baerm56/477grp14/led_sensor/3d_daughterboard_v0_2.jpg

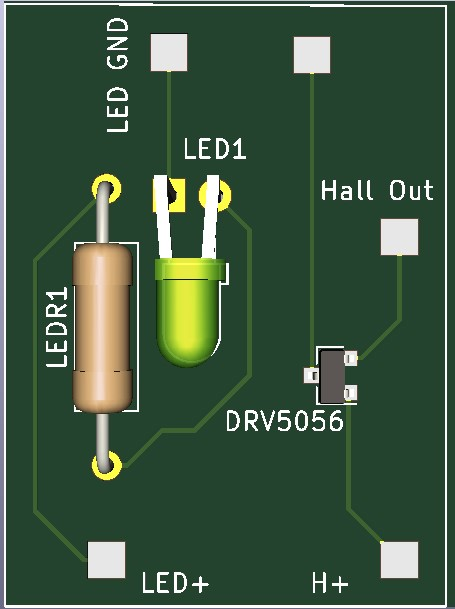
led_sensor/3d_daughterboard_v0_2.jpg
