baerm56/477grp14/Main_Board/Main_Board.png

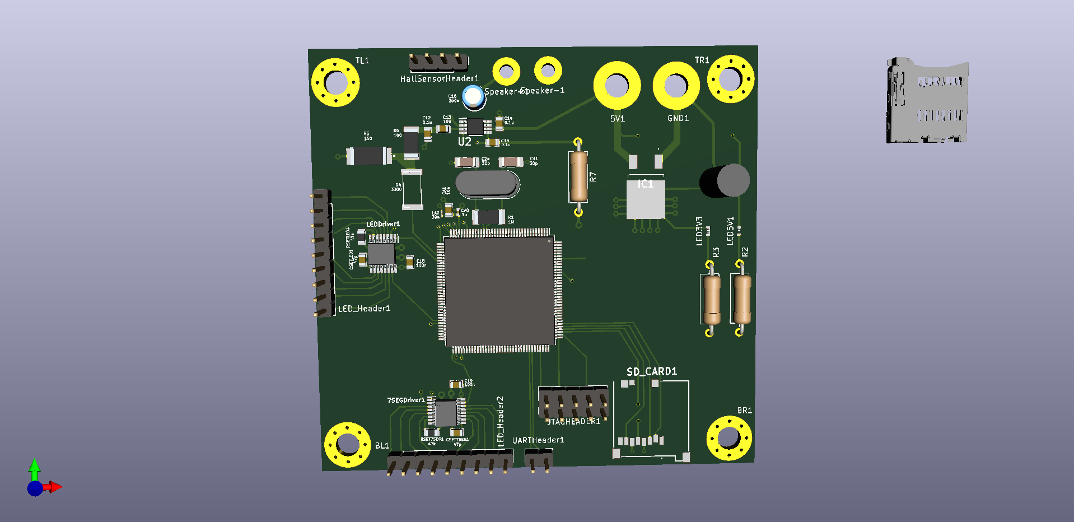
Main_Board/Main_Board.png
