baerm56/477grp14/README.md

# 477grp14
This is our senior design project
