baerm56/477grp14/led_sensor/3d_daughterboard.jpg

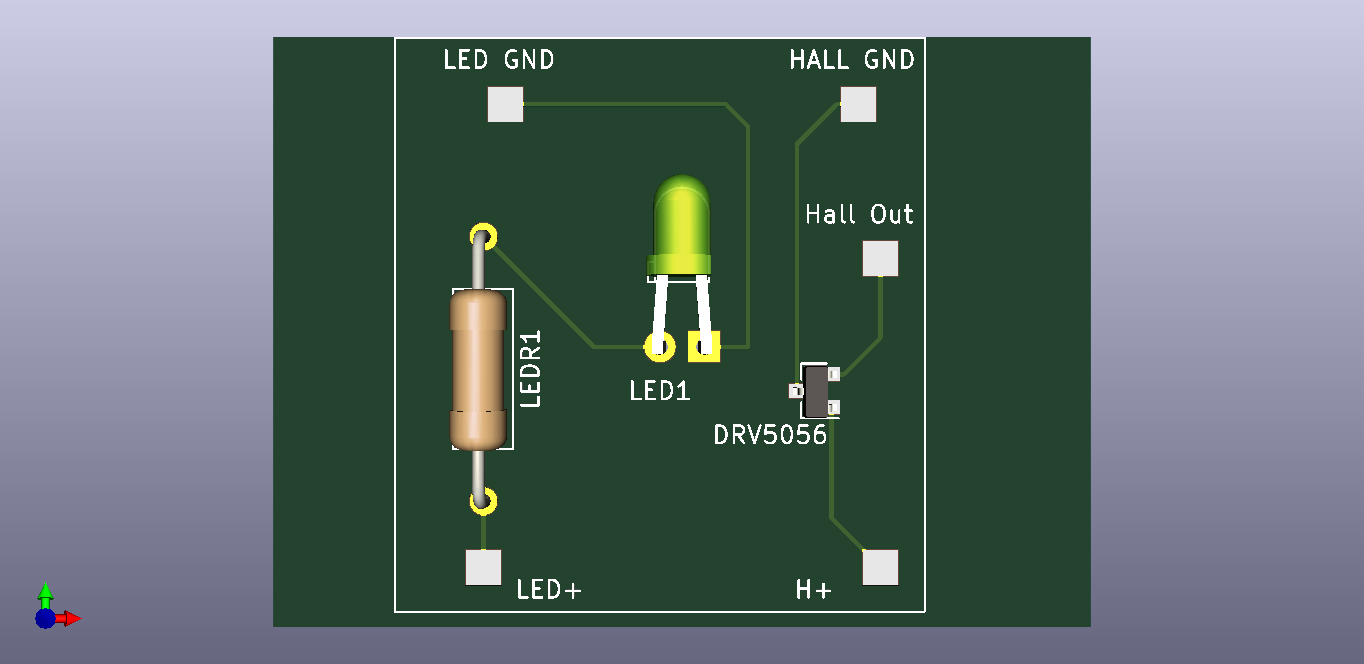
led_sensor/3d_daughterboard.jpg
