baerm56/477grp14/led_sensor/daughterboard_pcb.jpg

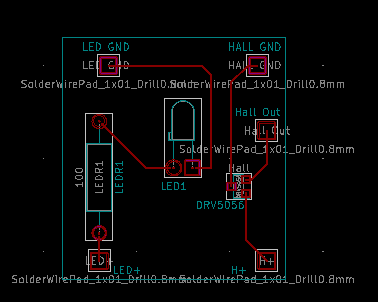
led_sensor/daughterboard_pcb.jpg
