baerm56/477grp14/led_sensor/NewDaughterboard.png

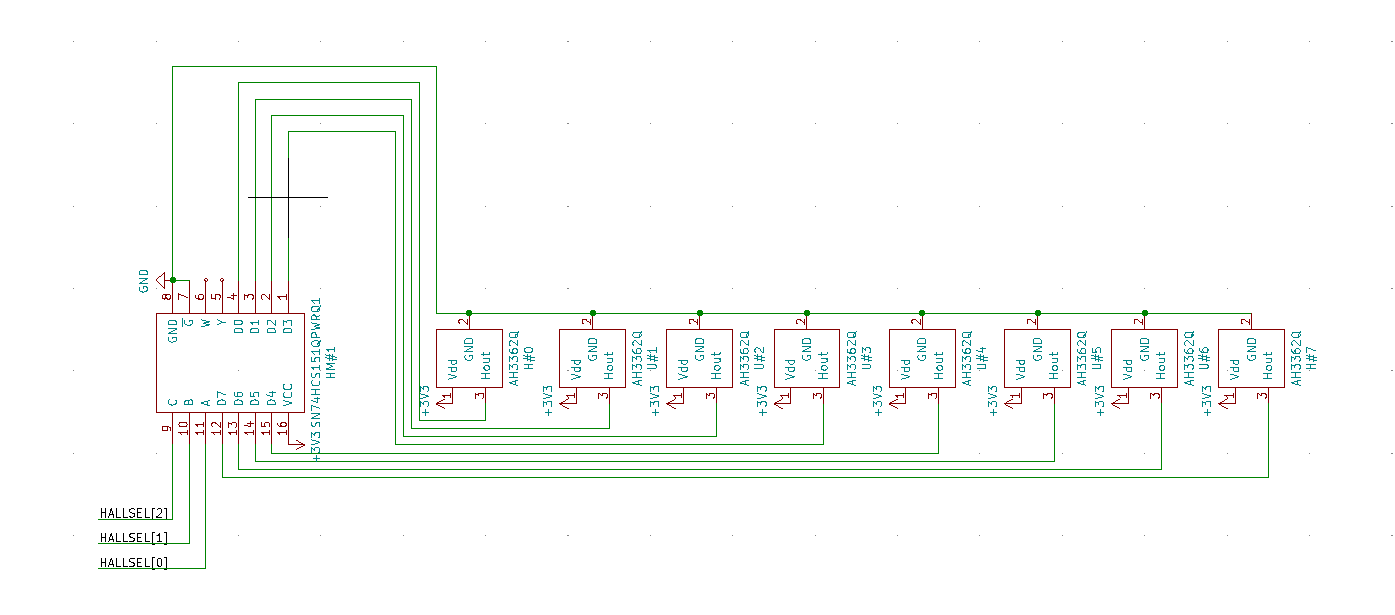
led_sensor/NewDaughterboard.png
