baerm56/477grp14/led_sensor/PCB-Daughterboard.png

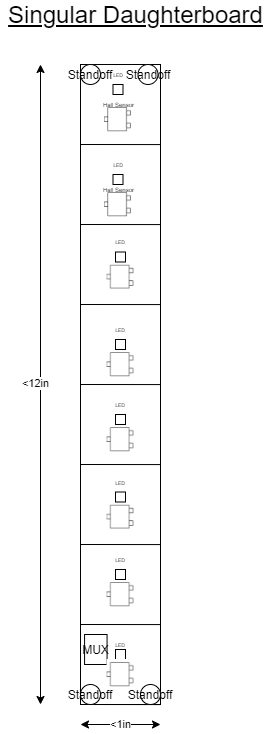
led_sensor/PCB-Daughterboard.png
