baerm56/477grp14/led_sensor/PCB-Daughterboards Layout.png

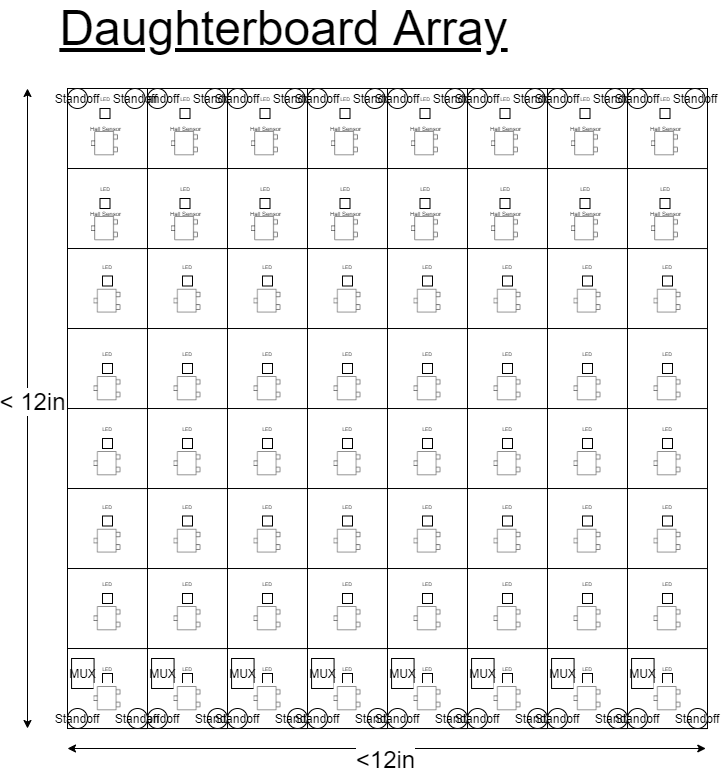
led_sensor/PCB-Daughterboards Layout.png
