baerm56/477grp14/Main_Board/Main_Board_3.png

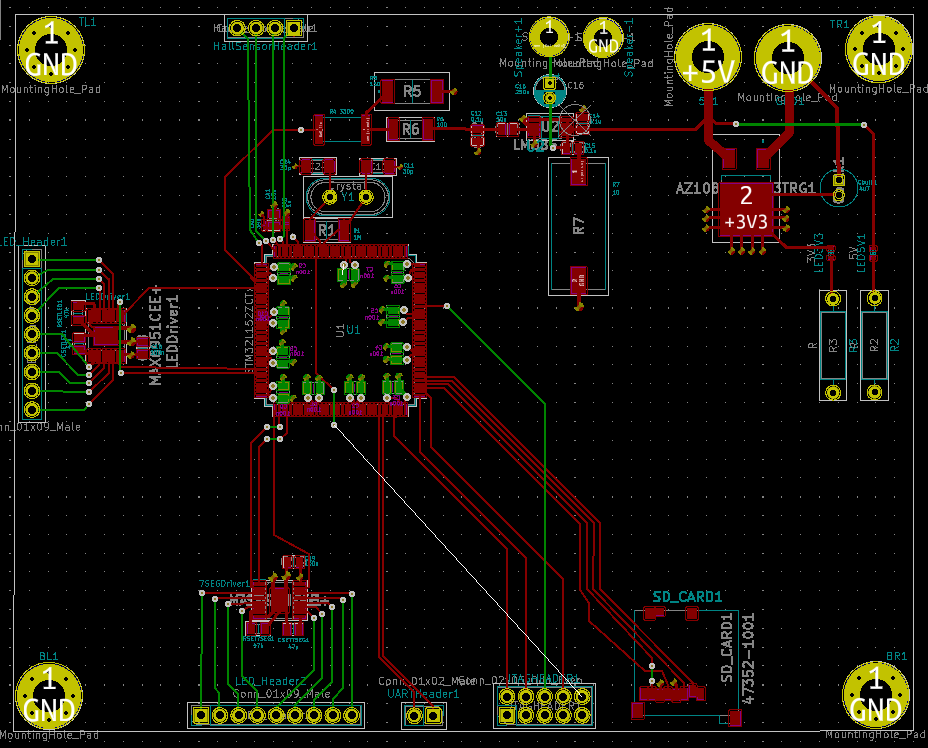
Main_Board/Main_Board_3.png
