baerm56/477grp14/Main_Board/MainBoardv0_1.jpg

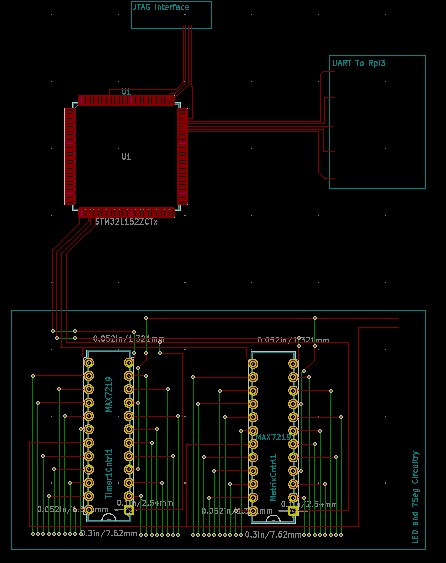
Main_Board/MainBoardv0_1.jpg
