baerm56/477grp14/Main_Board/PCB-Mainboard.png

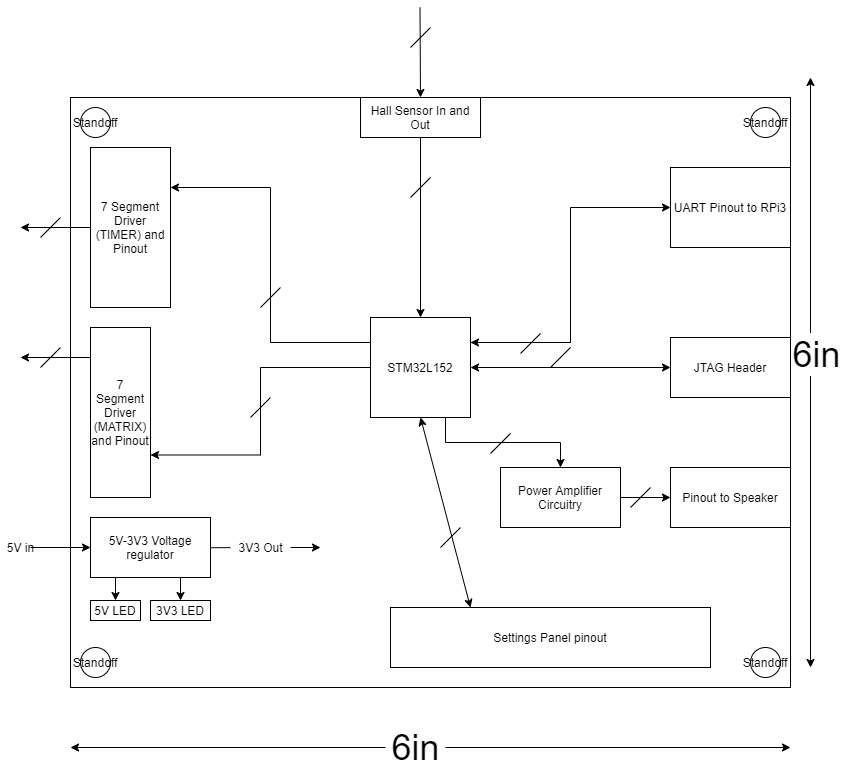
Main_Board/PCB-Mainboard.png
