baerm56/477grp14/Main_Board/PCB-Mainboard_2.png

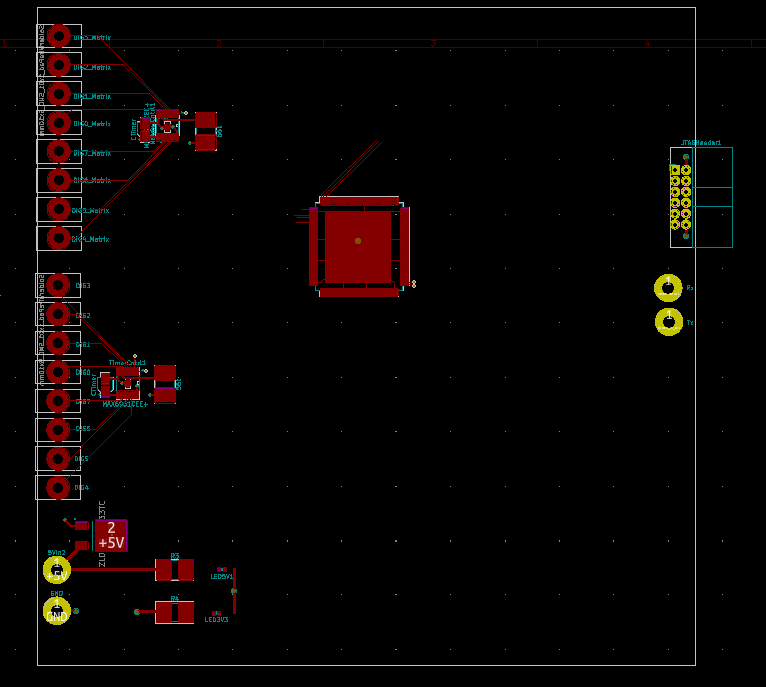
Main_Board/PCB-Mainboard_2.png
