baerm56/477grp14/PCB Screenshots/Led Daughterboard/Led_Hall_Circuit_pcb.png

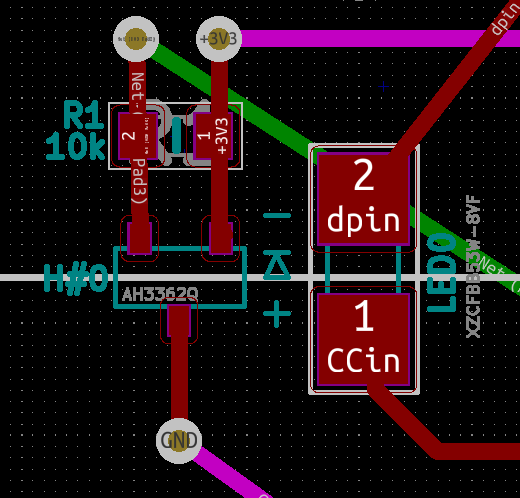
PCB Screenshots/Led Daughterboard/Led_Hall_Circuit_pcb.png
