baerm56/477grp14/PCB Screenshots/Led Daughterboard/Multiplexer_pcb.png

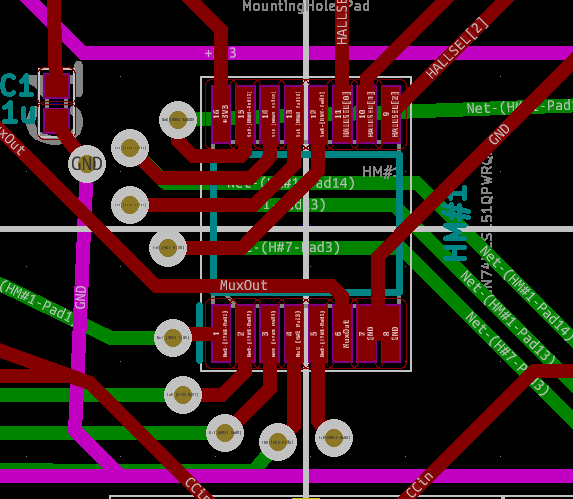
PCB Screenshots/Led Daughterboard/Multiplexer_pcb.png
