baerm56/477grp14/PCB Screenshots/Mainboard/7Seg_Driver_Circuit_pcb.png

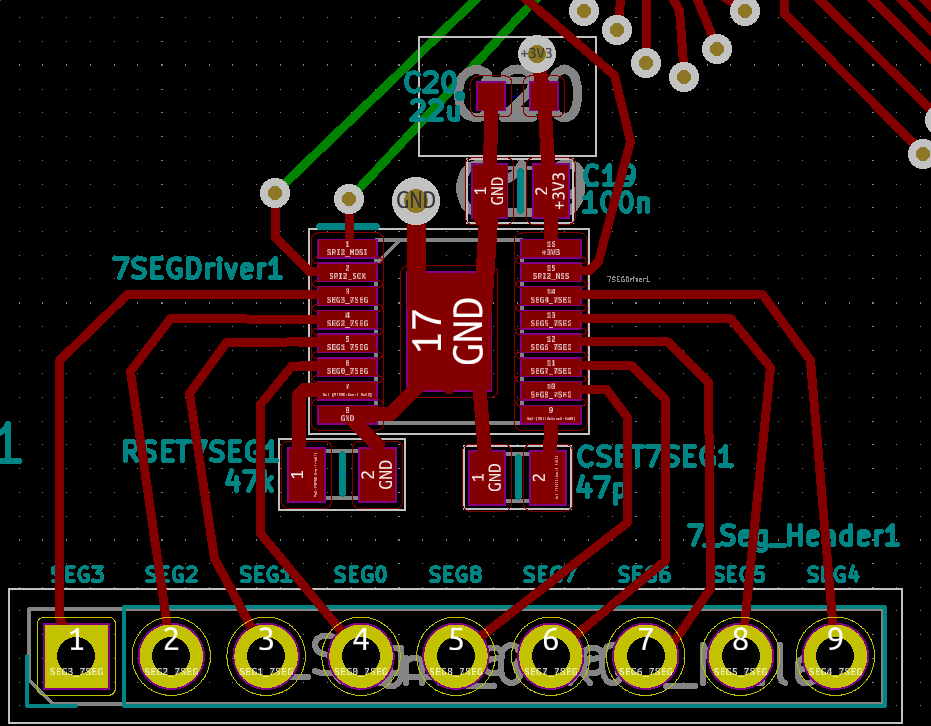
PCB Screenshots/Mainboard/7Seg_Driver_Circuit_pcb.png
