baerm56/477grp14/PCB Screenshots/Mainboard/Analog_Decoupling_pcb.png

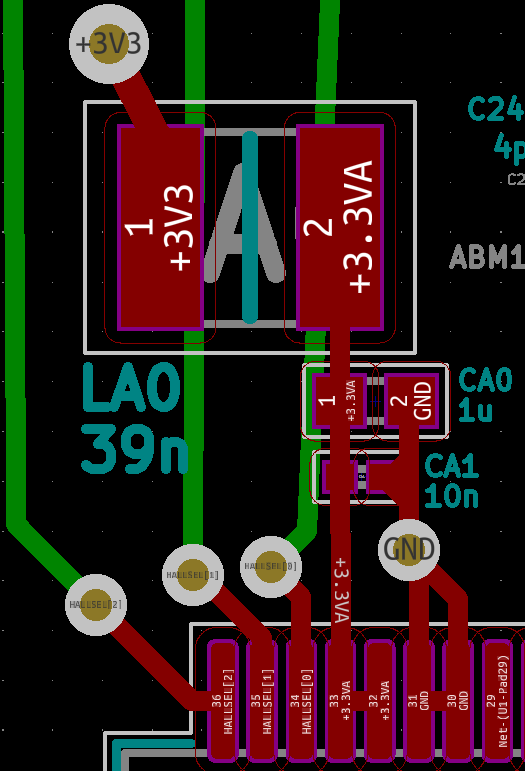
PCB Screenshots/Mainboard/Analog_Decoupling_pcb.png
