baerm56/477grp14/PCB Screenshots/Mainboard/Crystal_pcb.png

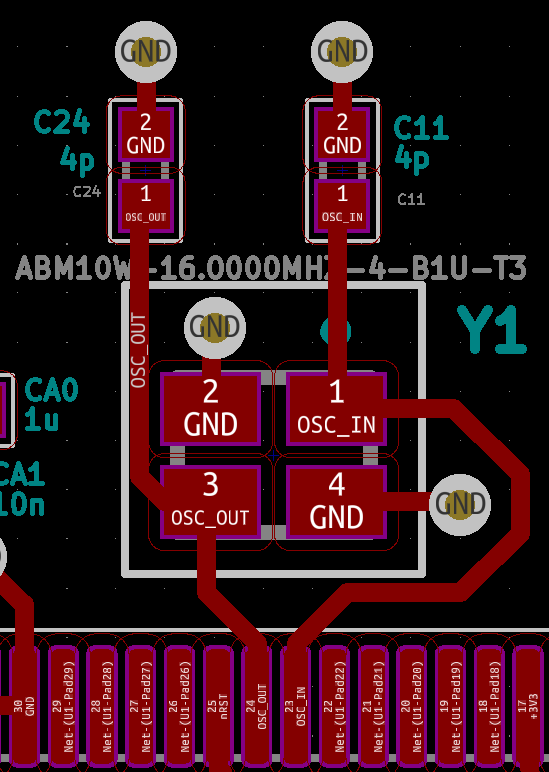
PCB Screenshots/Mainboard/Crystal_pcb.png
