baerm56/477grp14/PCB Screenshots/Mainboard/Full_Board_Blayer_pcb.png

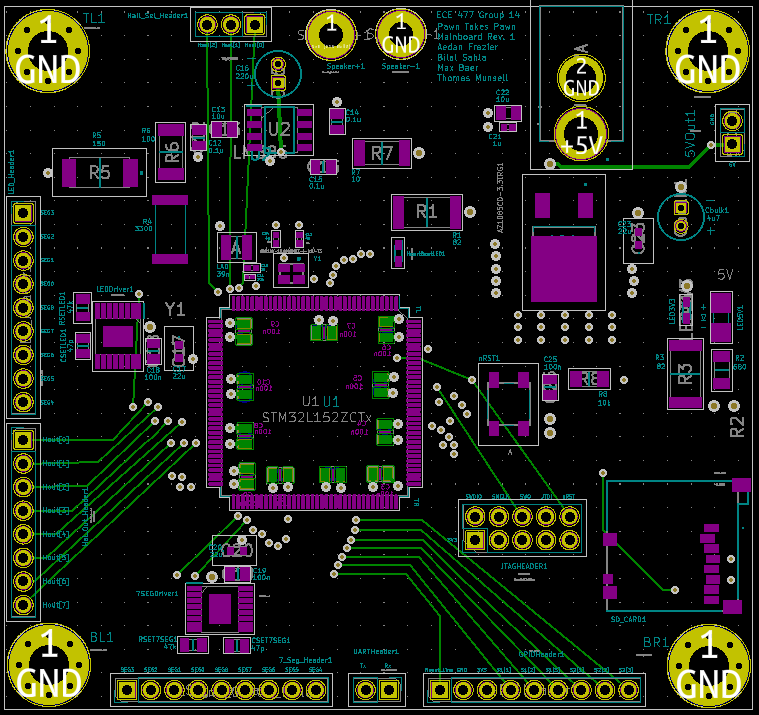
PCB Screenshots/Mainboard/Full_Board_Blayer_pcb.png
