baerm56/477grp14/PCB Screenshots/Mainboard/Full_Board_Flayer_pcb.png

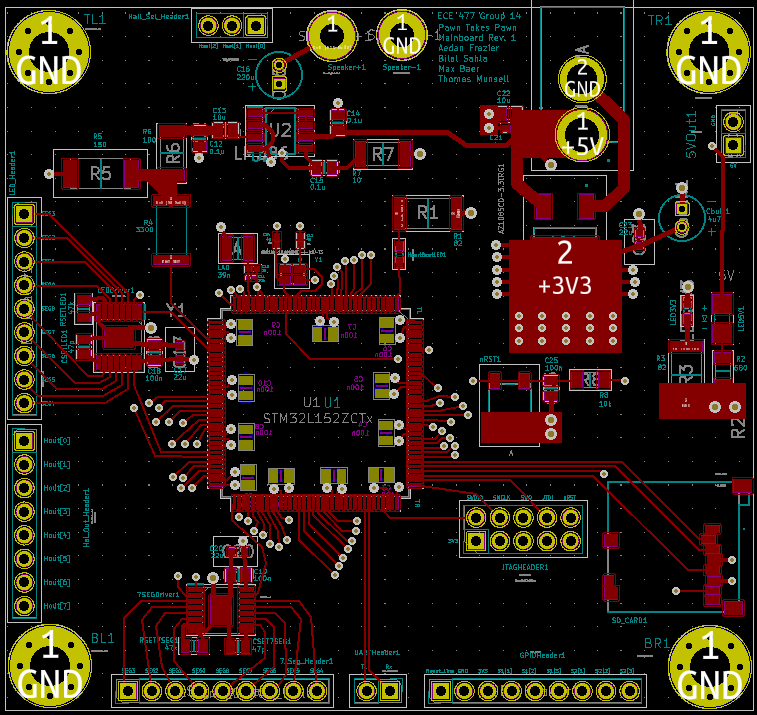
PCB Screenshots/Mainboard/Full_Board_Flayer_pcb.png
