baerm56/477grp14/PCB Screenshots/Mainboard/GPIO_Header_pcb.png

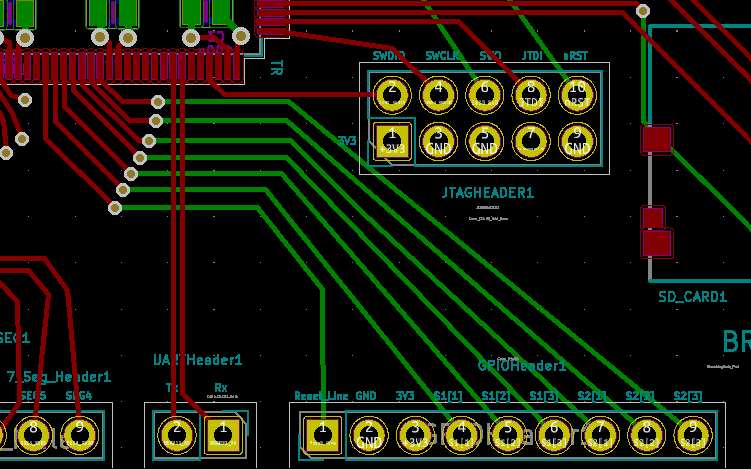
PCB Screenshots/Mainboard/GPIO_Header_pcb.png
