baerm56/477grp14/PCB Screenshots/Mainboard/Hall_Receive_Header_pcb.png

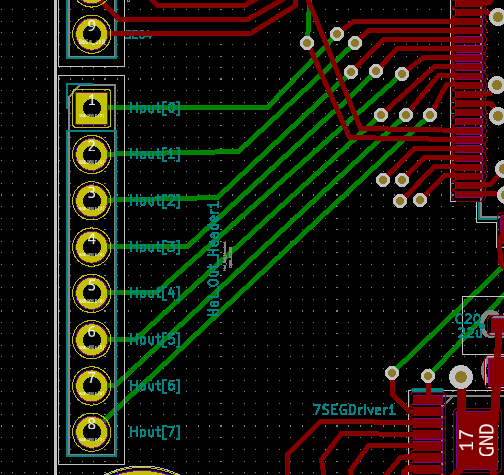
PCB Screenshots/Mainboard/Hall_Receive_Header_pcb.png
