baerm56/477grp14/PCB Screenshots/Mainboard/Hall_Select_Circuit_pcb.png

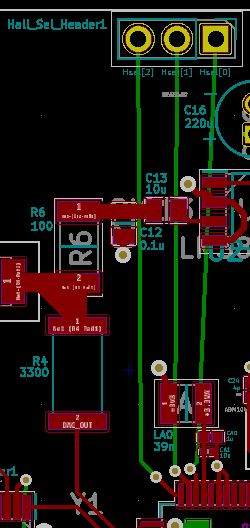
PCB Screenshots/Mainboard/Hall_Select_Circuit_pcb.png
