baerm56/477grp14/PCB Screenshots/Mainboard/Heartbeat_LED_pcb.png

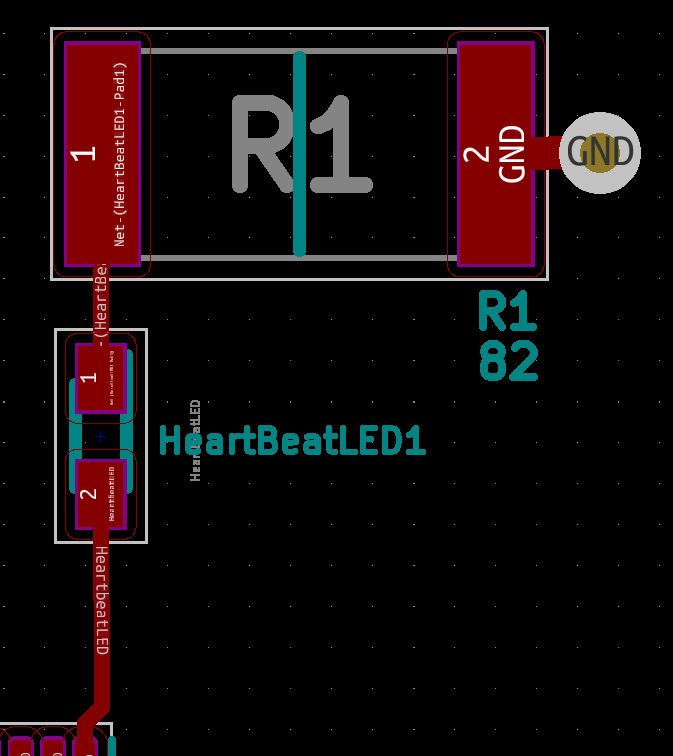
PCB Screenshots/Mainboard/Heartbeat_LED_pcb.png
