baerm56/477grp14/PCB Screenshots/Mainboard/JTAGSWD_Header_pcb.png

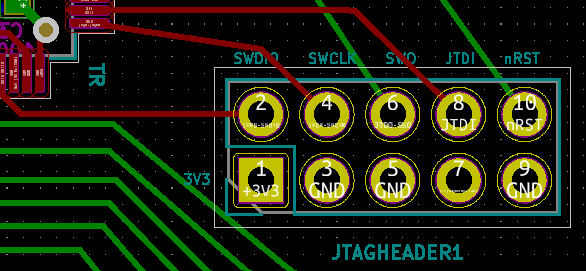
PCB Screenshots/Mainboard/JTAGSWD_Header_pcb.png
