baerm56/477grp14/PCB Screenshots/Mainboard/LDO_5Vin_Circuit_pcb.png

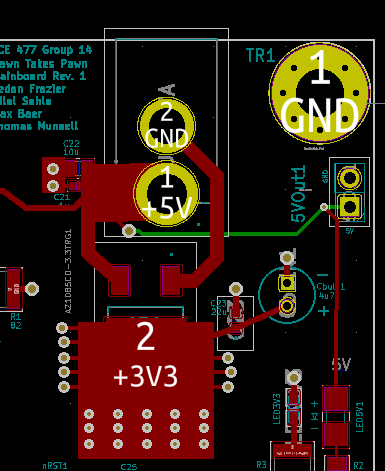
PCB Screenshots/Mainboard/LDO_5Vin_Circuit_pcb.png
