baerm56/477grp14/PCB Screenshots/Mainboard/LED_Driver_Circuit_pcb.png

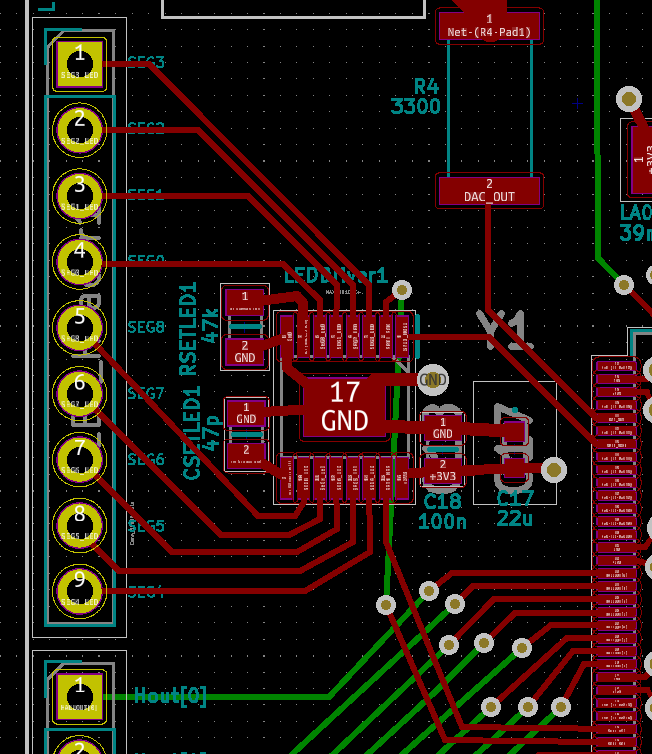
PCB Screenshots/Mainboard/LED_Driver_Circuit_pcb.png
