baerm56/477grp14/PCB Screenshots/Mainboard/MCU_Decoupling_pcb.png

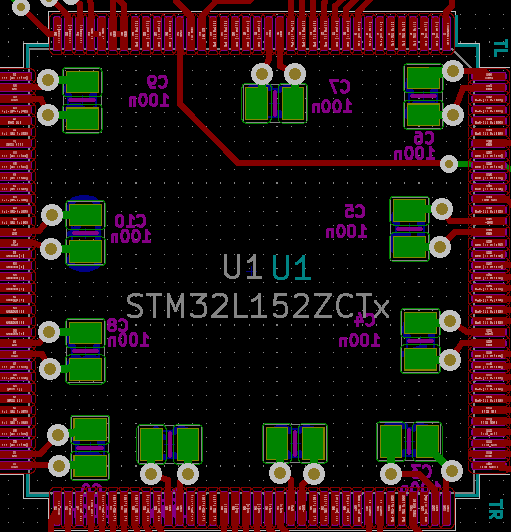
PCB Screenshots/Mainboard/MCU_Decoupling_pcb.png
