baerm56/477grp14/PCB Screenshots/Mainboard/Power_Circuit_pcb.png

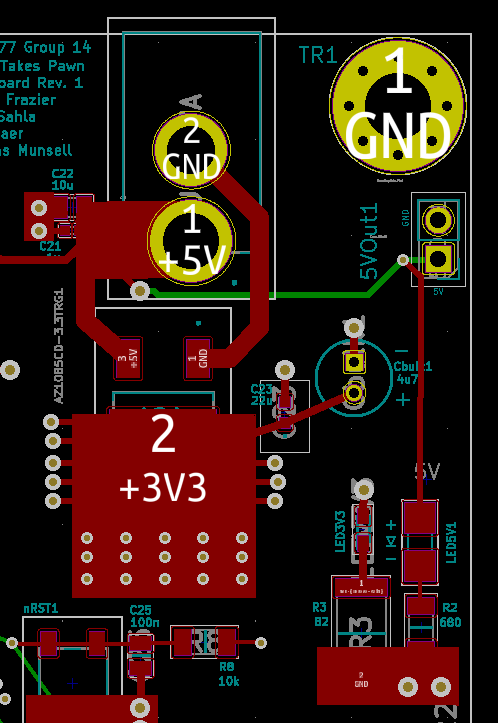
PCB Screenshots/Mainboard/Power_Circuit_pcb.png
