baerm56/477grp14/PCB Screenshots/Mainboard/PWR_Good_LED_Circuit_pcb.png

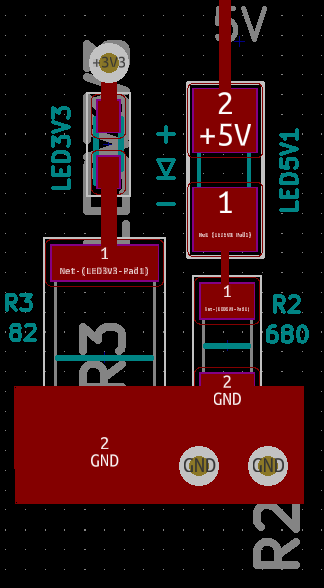
PCB Screenshots/Mainboard/PWR_Good_LED_Circuit_pcb.png
