baerm56/477grp14/PCB Screenshots/Mainboard/Reset_Circuit_pcb.png

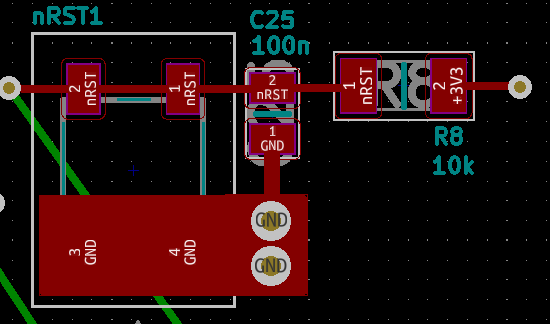
PCB Screenshots/Mainboard/Reset_Circuit_pcb.png
