baerm56/477grp14/PCB Screenshots/Mainboard/SDCard_Circuit_pcb.png

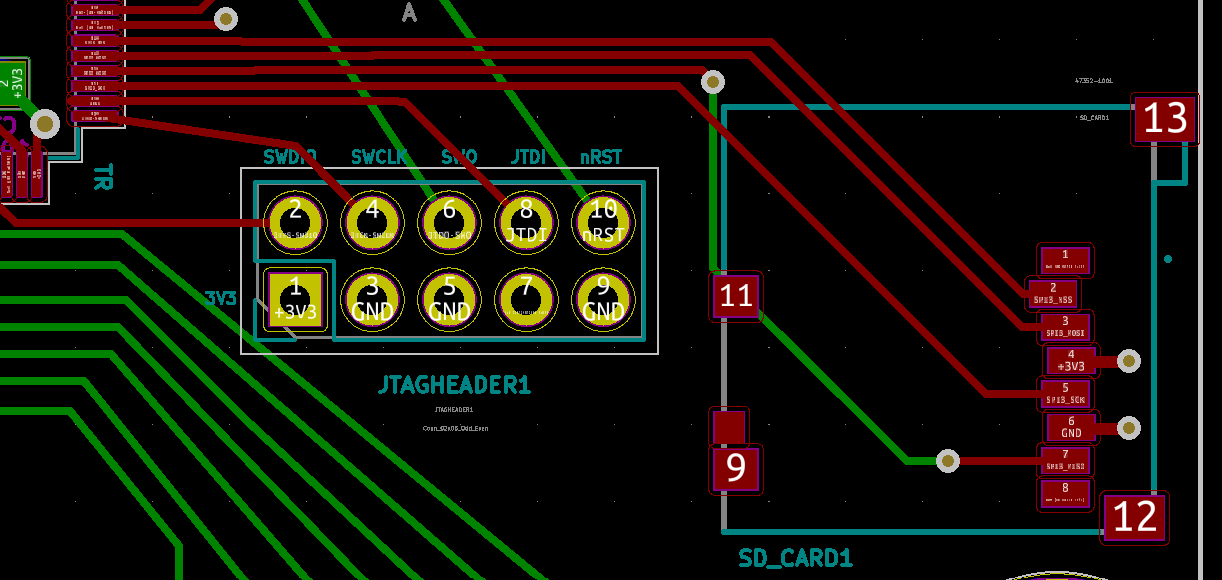
PCB Screenshots/Mainboard/SDCard_Circuit_pcb.png
