baerm56/477grp14/PCB Screenshots/Mainboard/Speaker_Circuit_pcb.png

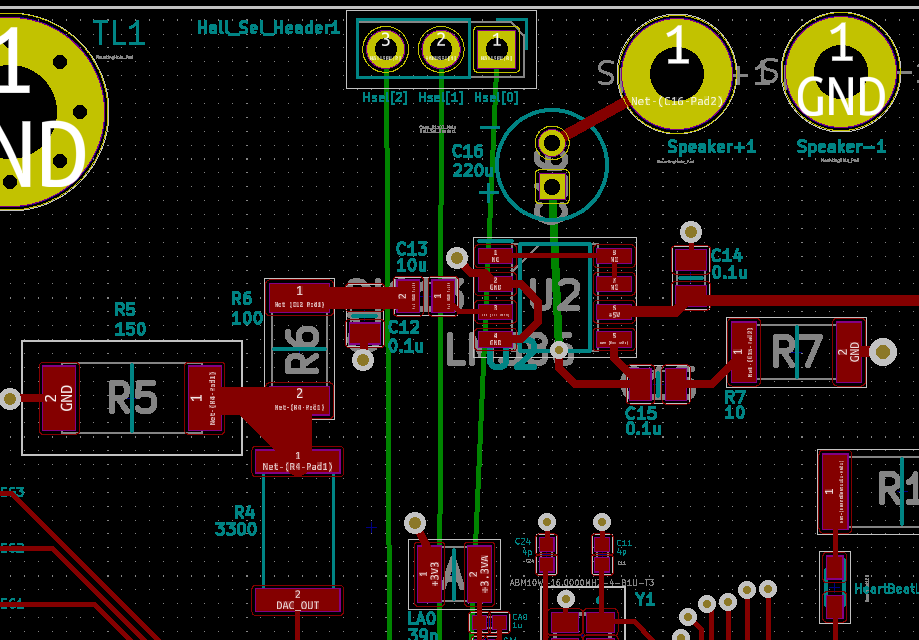
PCB Screenshots/Mainboard/Speaker_Circuit_pcb.png
