baerm56/477grp14/PCB Screenshots/Mainboard/STM32_pcb.png

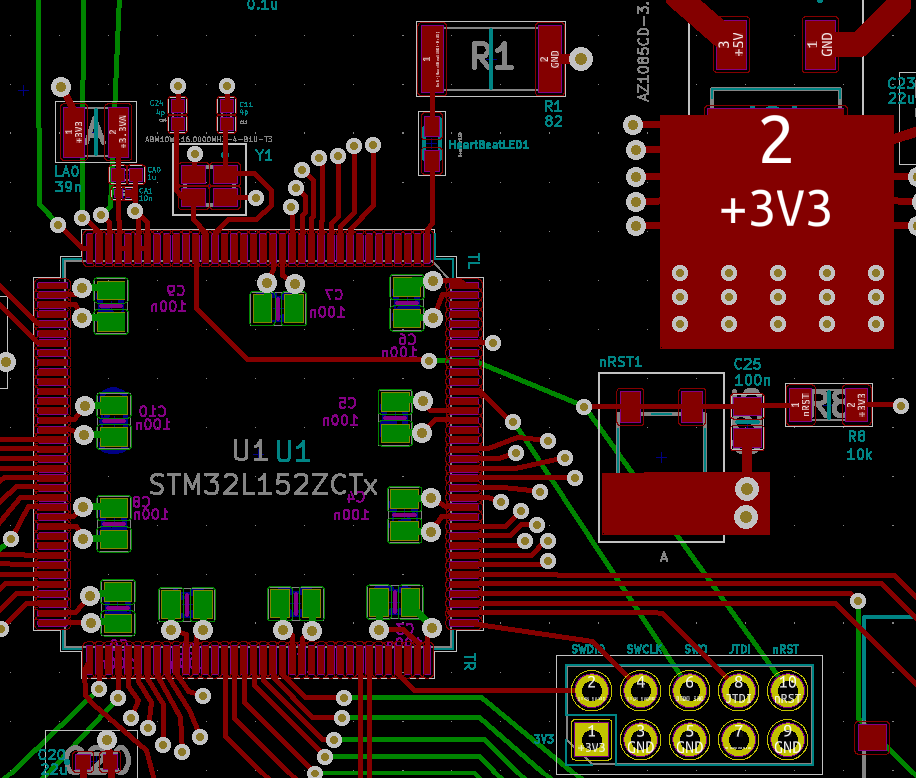
PCB Screenshots/Mainboard/STM32_pcb.png
