baerm56/477grp14/PCB Screenshots/Mainboard/UART_Header_pcb.png

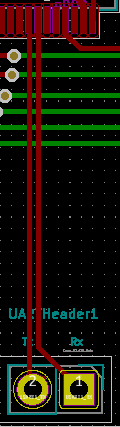
PCB Screenshots/Mainboard/UART_Header_pcb.png
