baerm56/477grp14/Schematic Screenshots/LED_Hall_Daughterboard/Daughterboard_schm.png

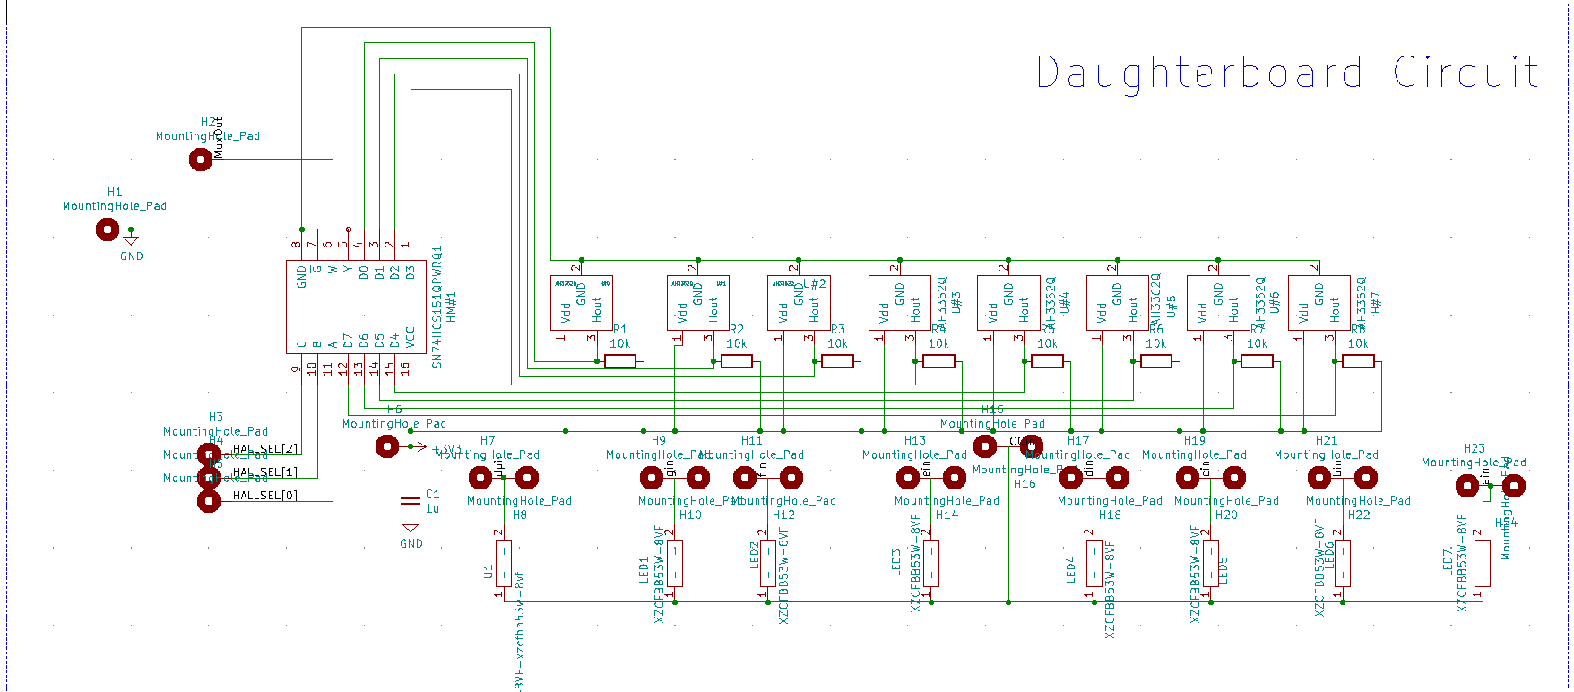
Schematic Screenshots/LED_Hall_Daughterboard/Daughterboard_schm.png
