baerm56/477grp14/Schematic Screenshots/LED_Hall_Daughterboard/Mounting_Holes_schm.png

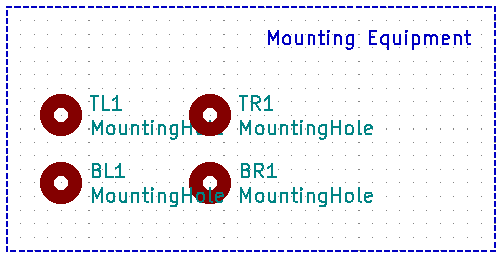
Schematic Screenshots/LED_Hall_Daughterboard/Mounting_Holes_schm.png
