baerm56/477grp14/Schematic Screenshots/Mainboard/5V_Header_schm.png

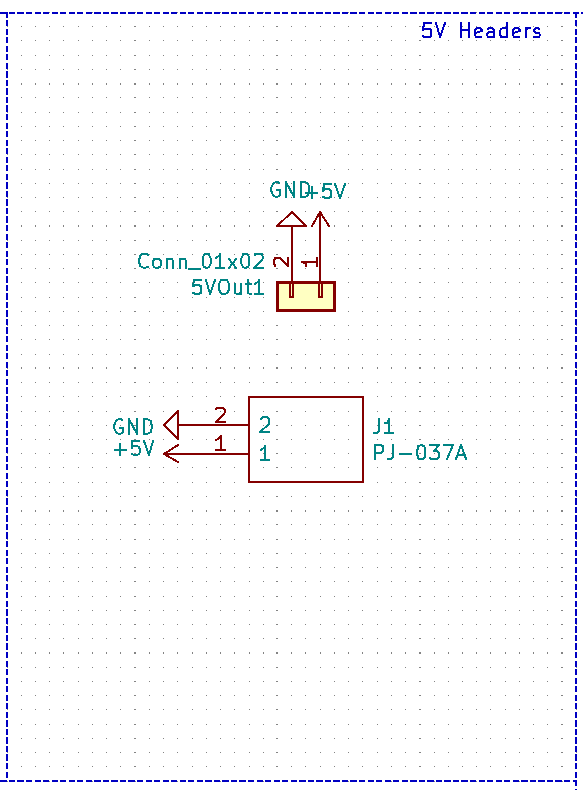
Schematic Screenshots/Mainboard/5V_Header_schm.png
