baerm56/477grp14/Schematic Screenshots/Mainboard/7Seg_LED_Driver_schm.png

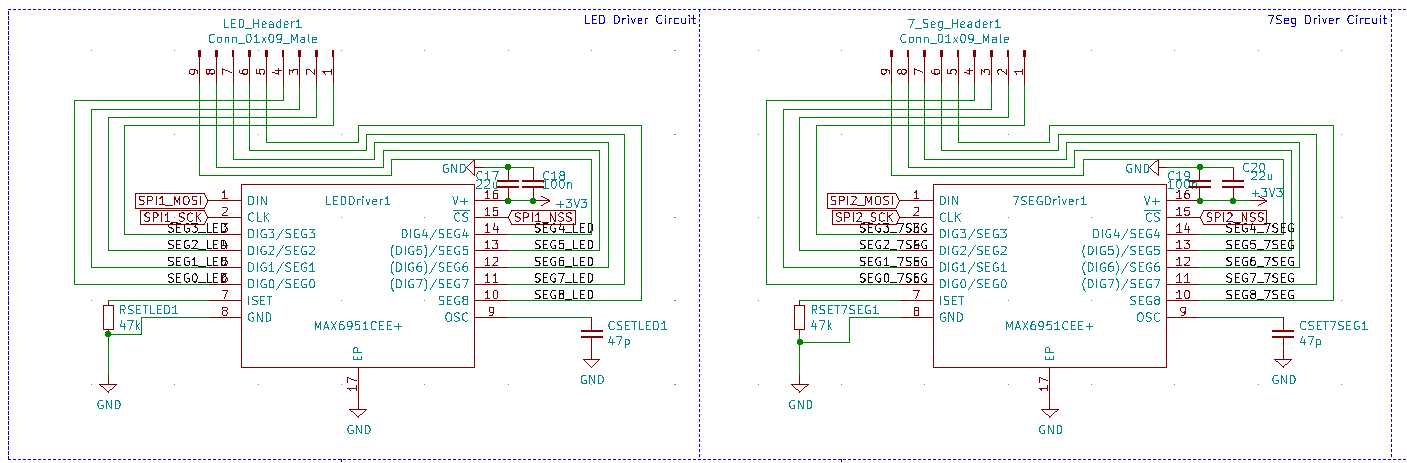
Schematic Screenshots/Mainboard/7Seg_LED_Driver_schm.png
