baerm56/477grp14/Schematic Screenshots/Mainboard/Analog_Decoupling_schm.png

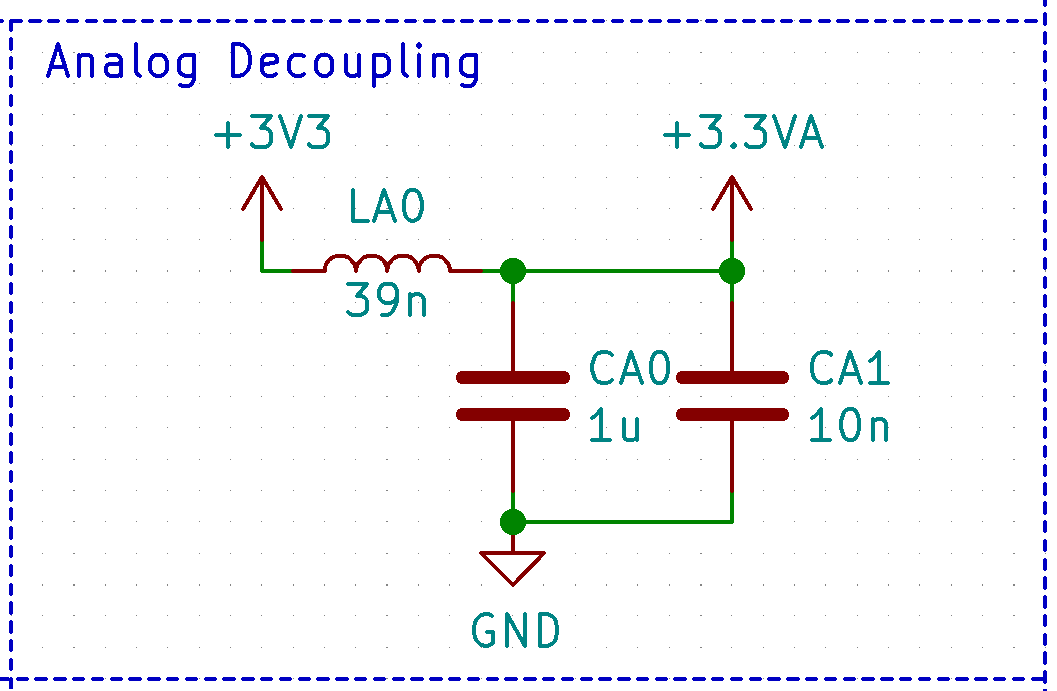
Schematic Screenshots/Mainboard/Analog_Decoupling_schm.png
