baerm56/477grp14/Schematic Screenshots/Mainboard/Crystal_Circuit_schm.png

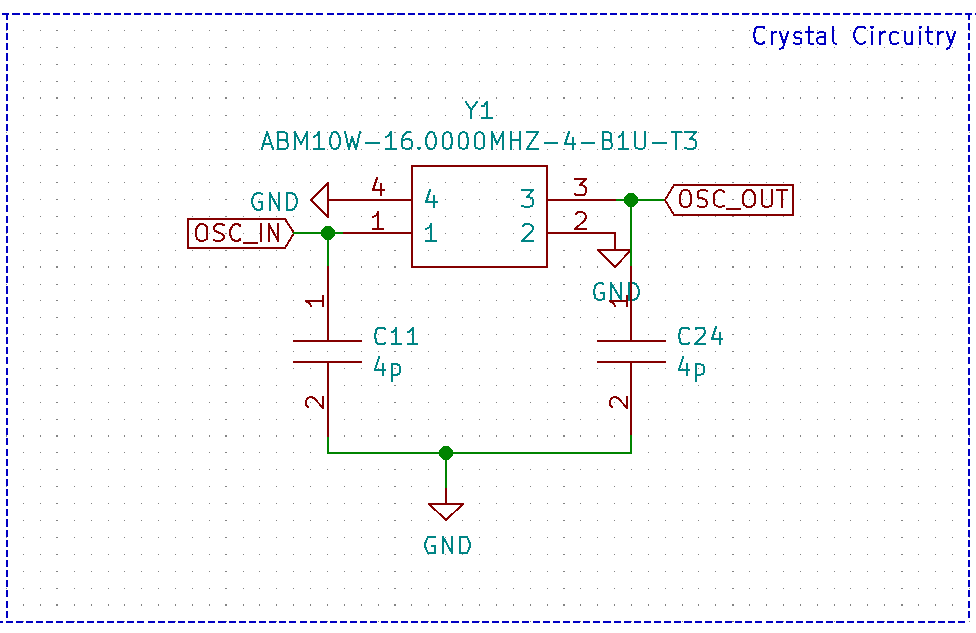
Schematic Screenshots/Mainboard/Crystal_Circuit_schm.png
