baerm56/477grp14/Schematic Screenshots/Mainboard/Decoupling_Caps_schm.png

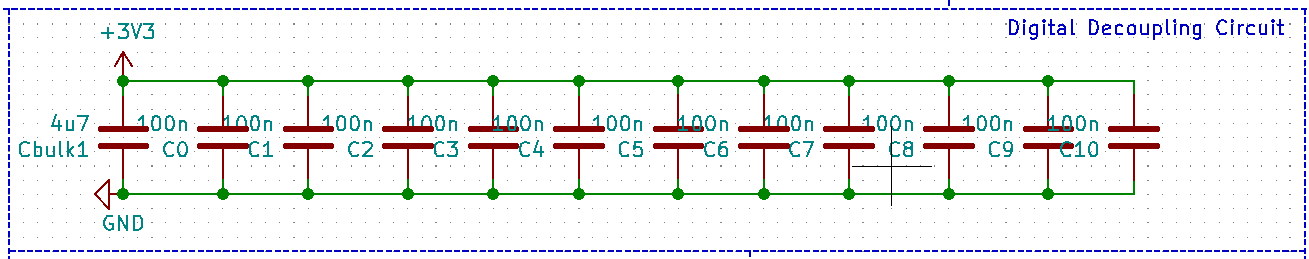
Schematic Screenshots/Mainboard/Decoupling_Caps_schm.png
