baerm56/477grp14/Schematic Screenshots/Mainboard/Full_Schematic_schm.png

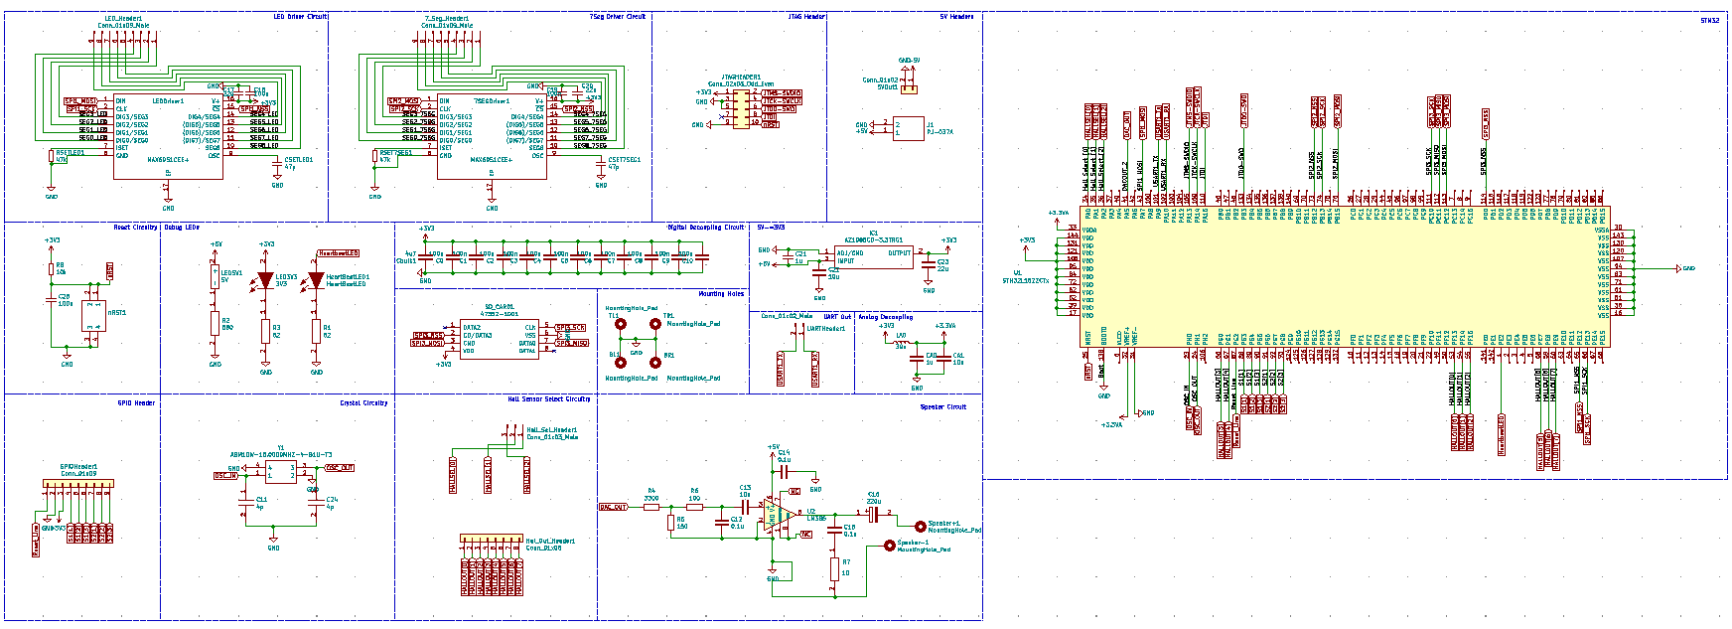
Schematic Screenshots/Mainboard/Full_Schematic_schm.png
