baerm56/477grp14/Schematic Screenshots/Mainboard/GPIO_Header_schm.png

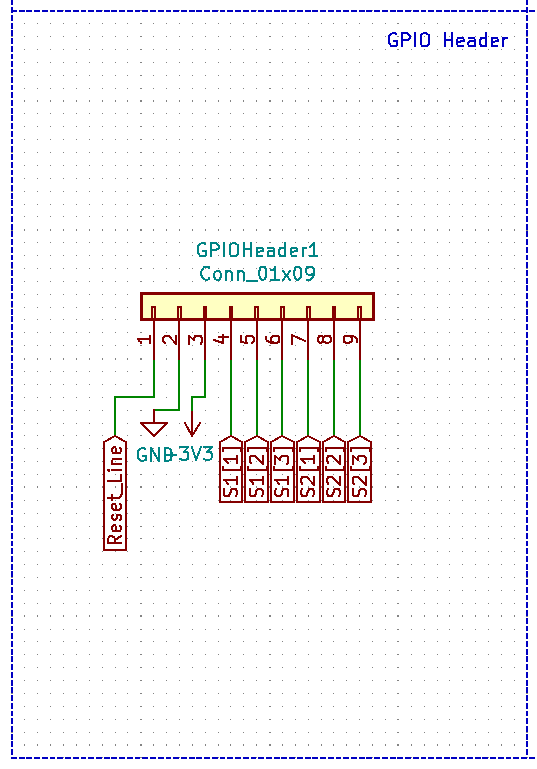
Schematic Screenshots/Mainboard/GPIO_Header_schm.png
