baerm56/477grp14/Schematic Screenshots/Mainboard/Hall_Cntrl_schm.png

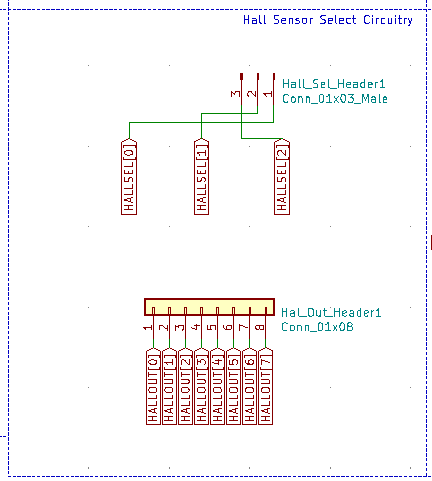
Schematic Screenshots/Mainboard/Hall_Cntrl_schm.png
