baerm56/477grp14/Schematic Screenshots/Mainboard/JTAG_Header_schm.png

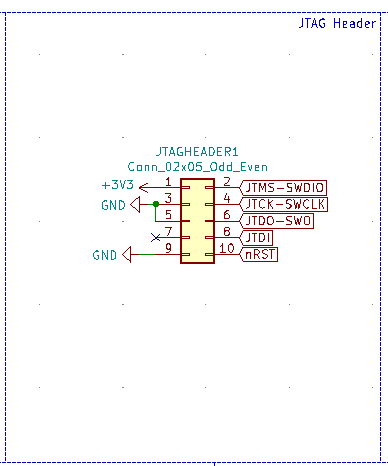
Schematic Screenshots/Mainboard/JTAG_Header_schm.png
