baerm56/477grp14/Schematic Screenshots/Mainboard/LDO_schm.png

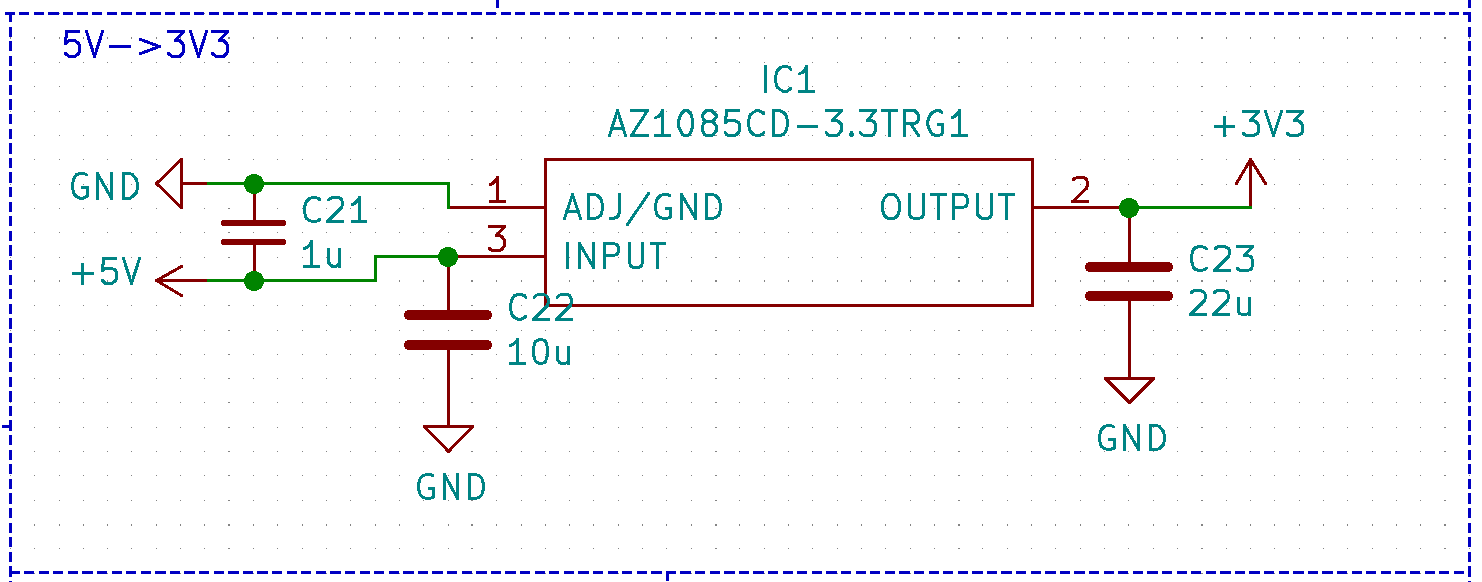
Schematic Screenshots/Mainboard/LDO_schm.png
