baerm56/477grp14/Schematic Screenshots/Mainboard/Mounting_Holes_schm.png

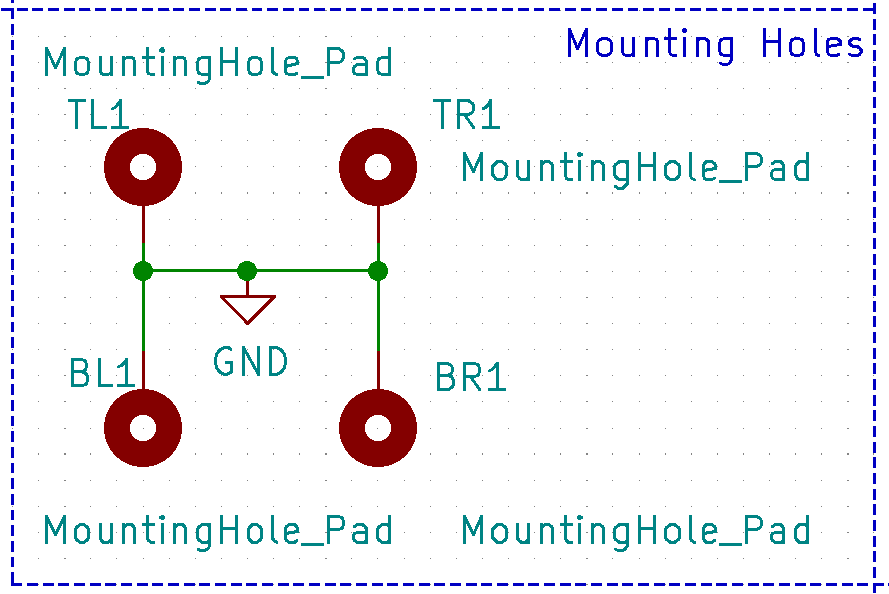
Schematic Screenshots/Mainboard/Mounting_Holes_schm.png
