baerm56/477grp14/Schematic Screenshots/Mainboard/Reset_Circuit_schm.png

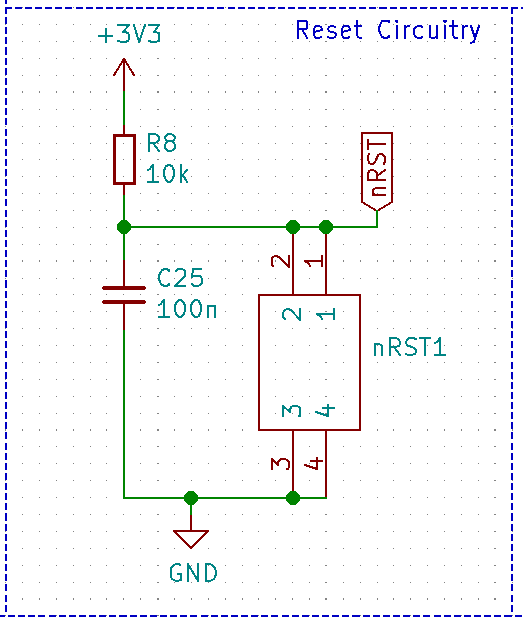
Schematic Screenshots/Mainboard/Reset_Circuit_schm.png
