baerm56/477grp14/Schematic Screenshots/Mainboard/Speaker_Circuit_schm.png

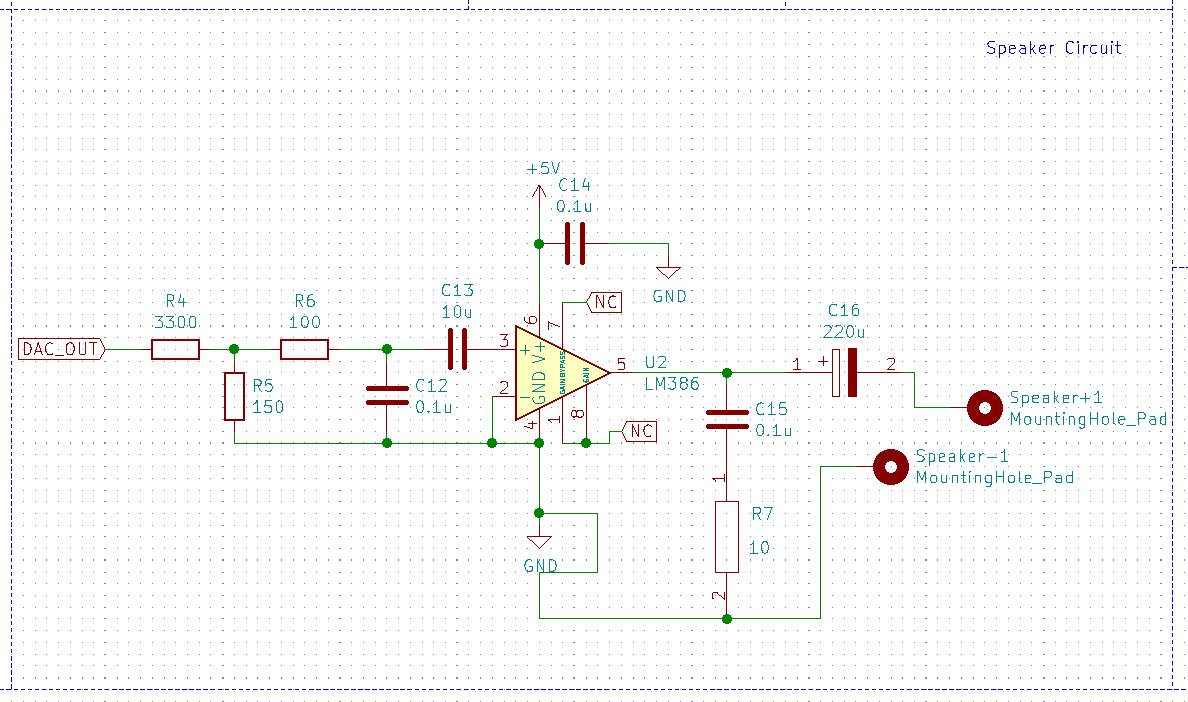
Schematic Screenshots/Mainboard/Speaker_Circuit_schm.png
