baerm56/477grp14/Schematic Screenshots/Mainboard/STM32_schm.png

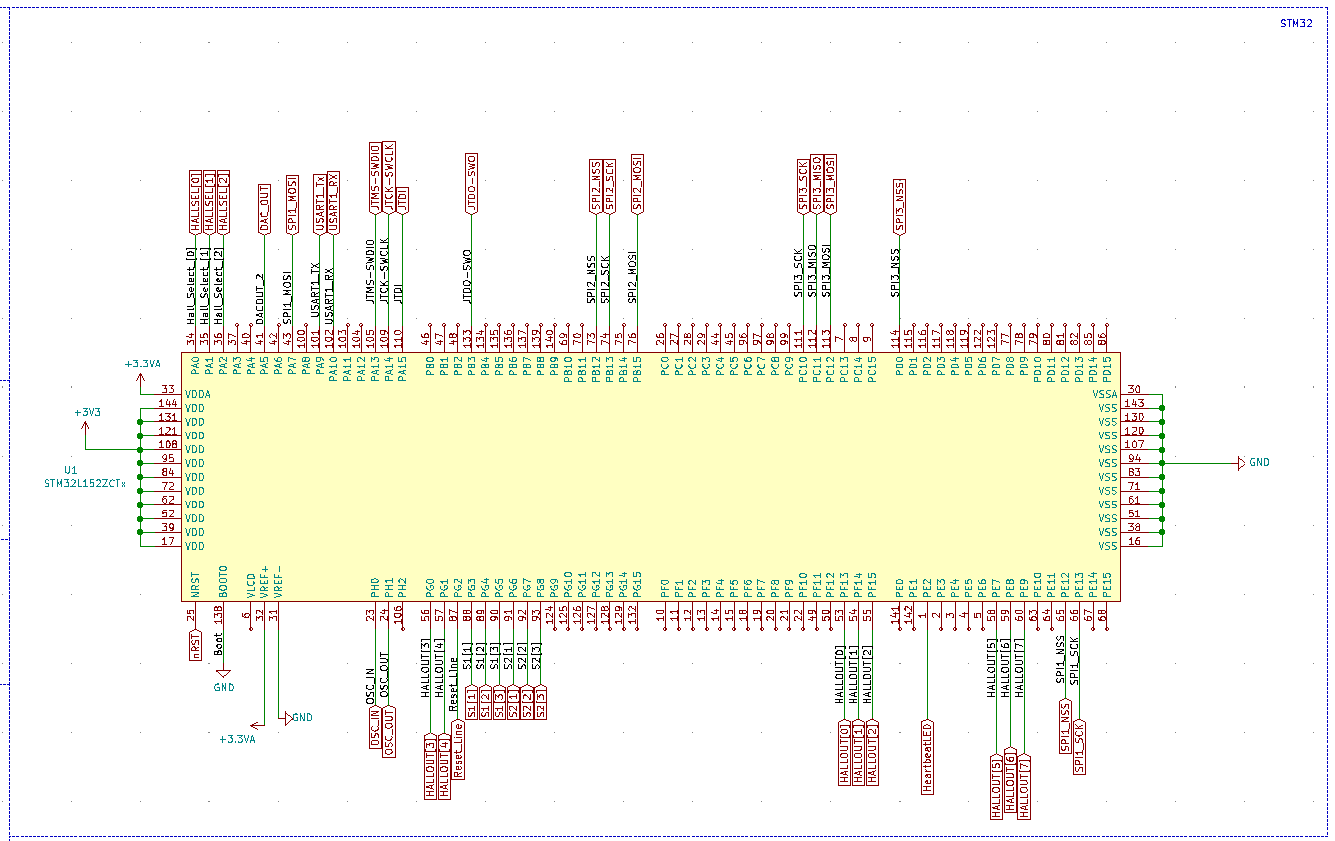
Schematic Screenshots/Mainboard/STM32_schm.png
