baerm56/477grp14/Schematic Screenshots/Mainboard/UART_Header_schm.png

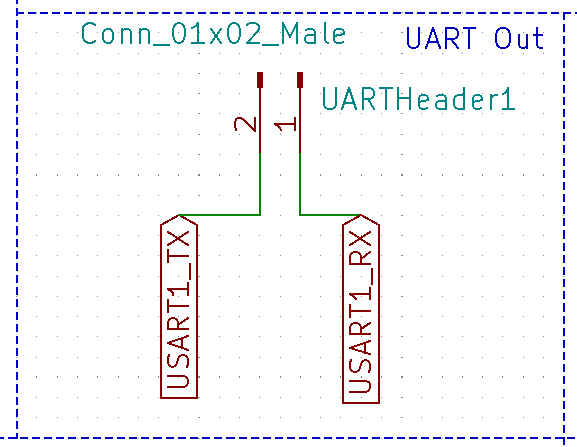
Schematic Screenshots/Mainboard/UART_Header_schm.png
