baerm56/477grp14/Schematic Screenshots/Mainboard/Debug_LEDs_schm.png

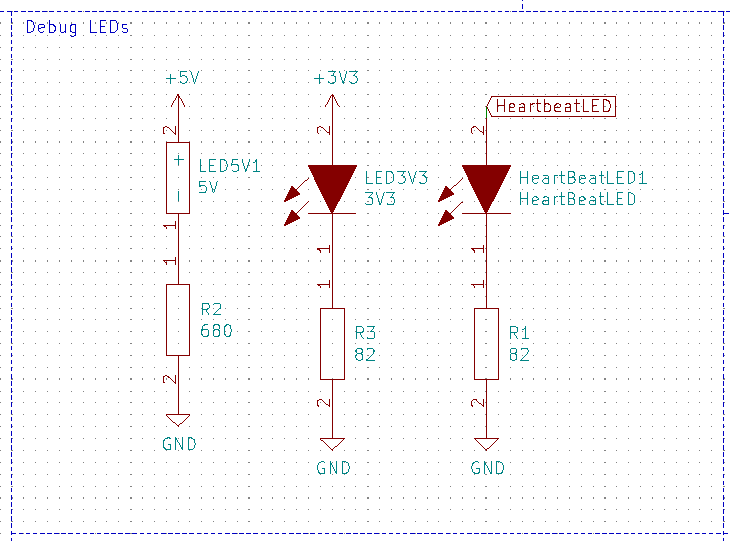
Schematic Screenshots/Mainboard/Debug_LEDs_schm.png
