baerm56/477grp14/Main_Board/Main_Board-B_Cu.pdf

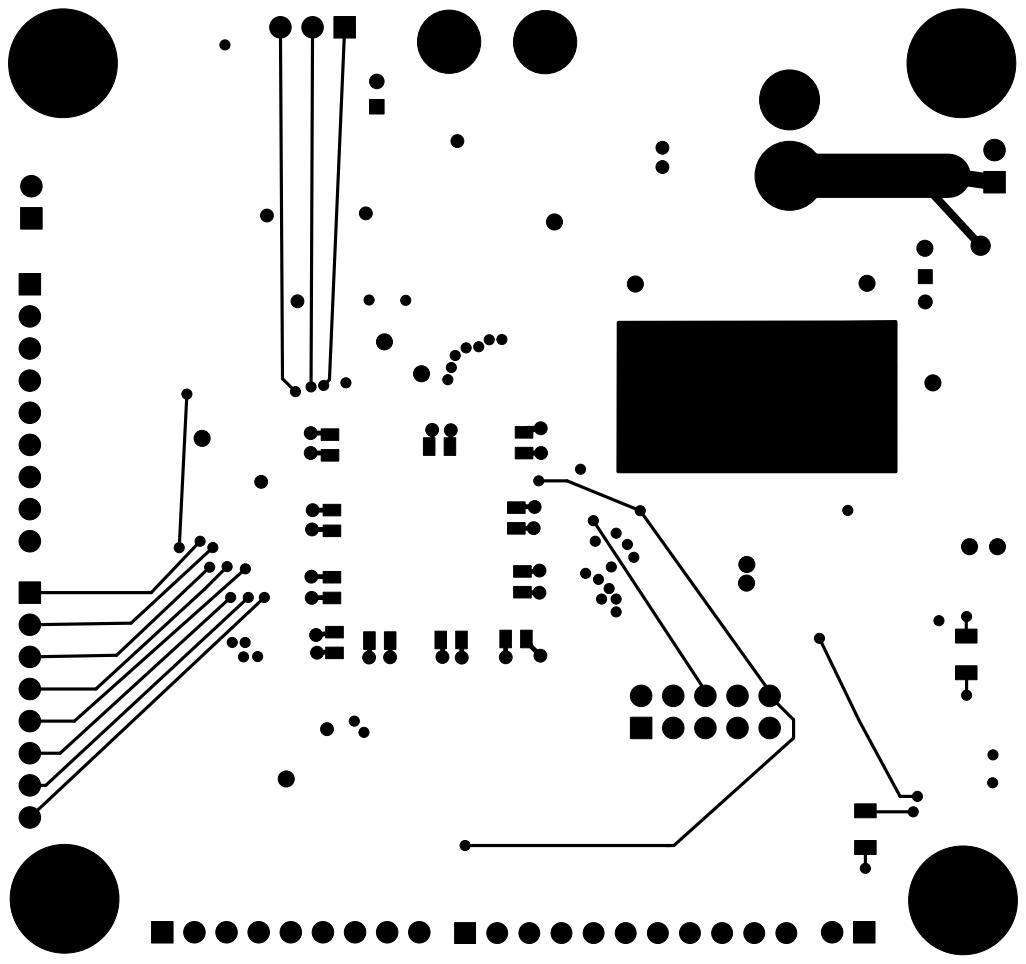
[picture p54: page 1]
