baerm56/477grp14/Main_Board/Main_Board-B_Mask.pdf

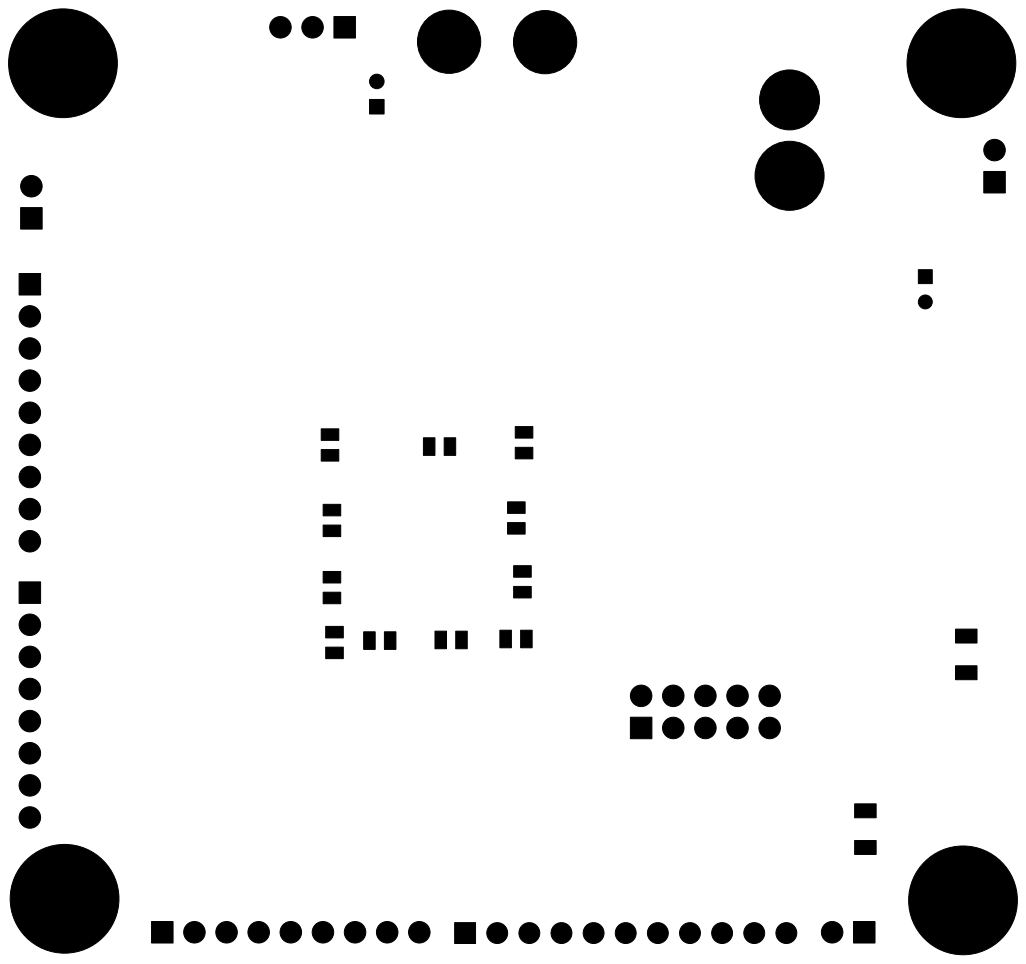
[picture p55: page 1]
