baerm56/477grp14/Main_Board/Main_Board-B_Paste.pdf

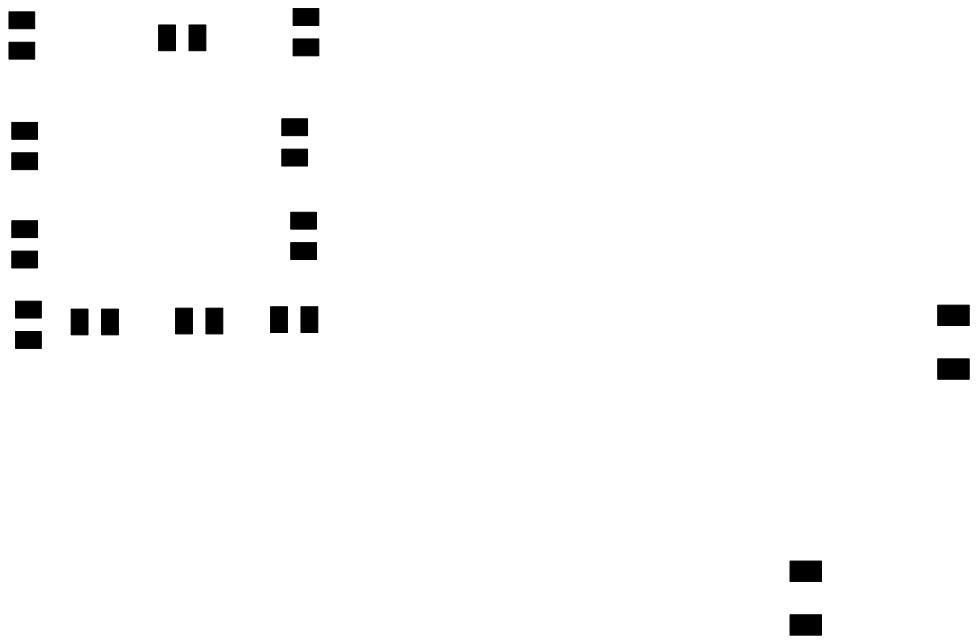
[picture p56: page 1]
