baerm56/477grp14/Main_Board/Main_Board-B_SilkS.pdf

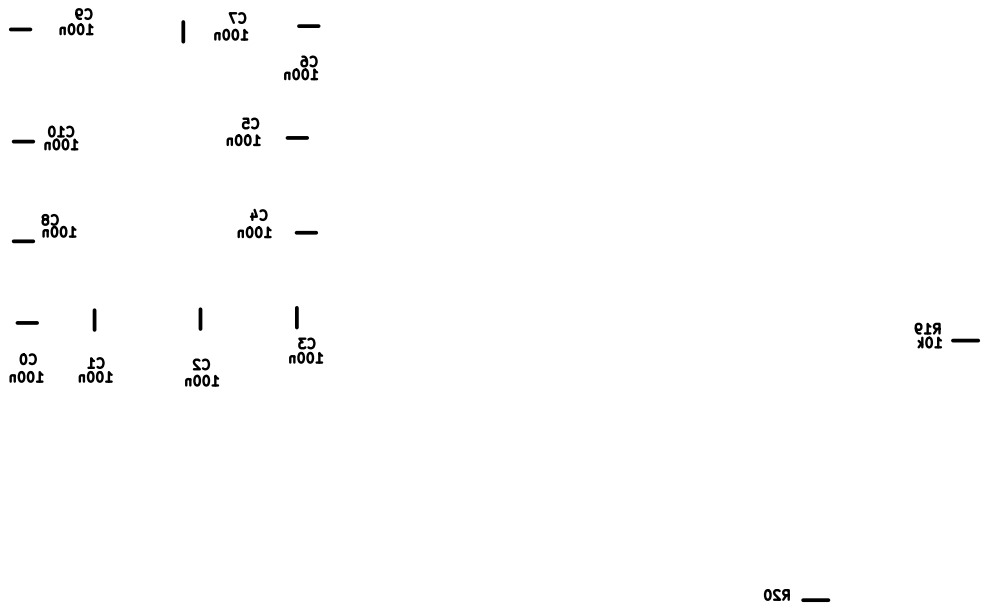
[picture p57: page 1]
