baerm56/477grp14/Main_Board/Main_Board-F_Cu.pdf

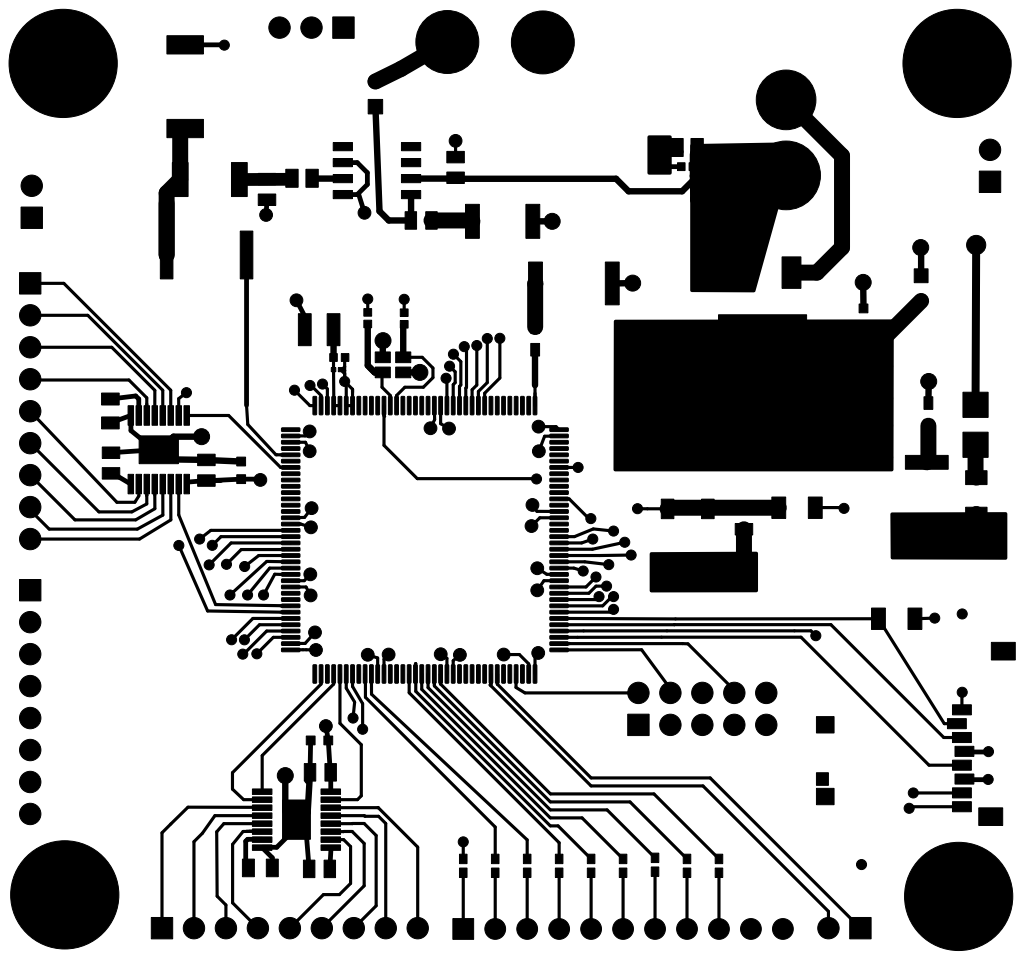
[picture p58: page 1]
