baerm56/477grp14/Main_Board/Main_Board-F_Mask.pdf

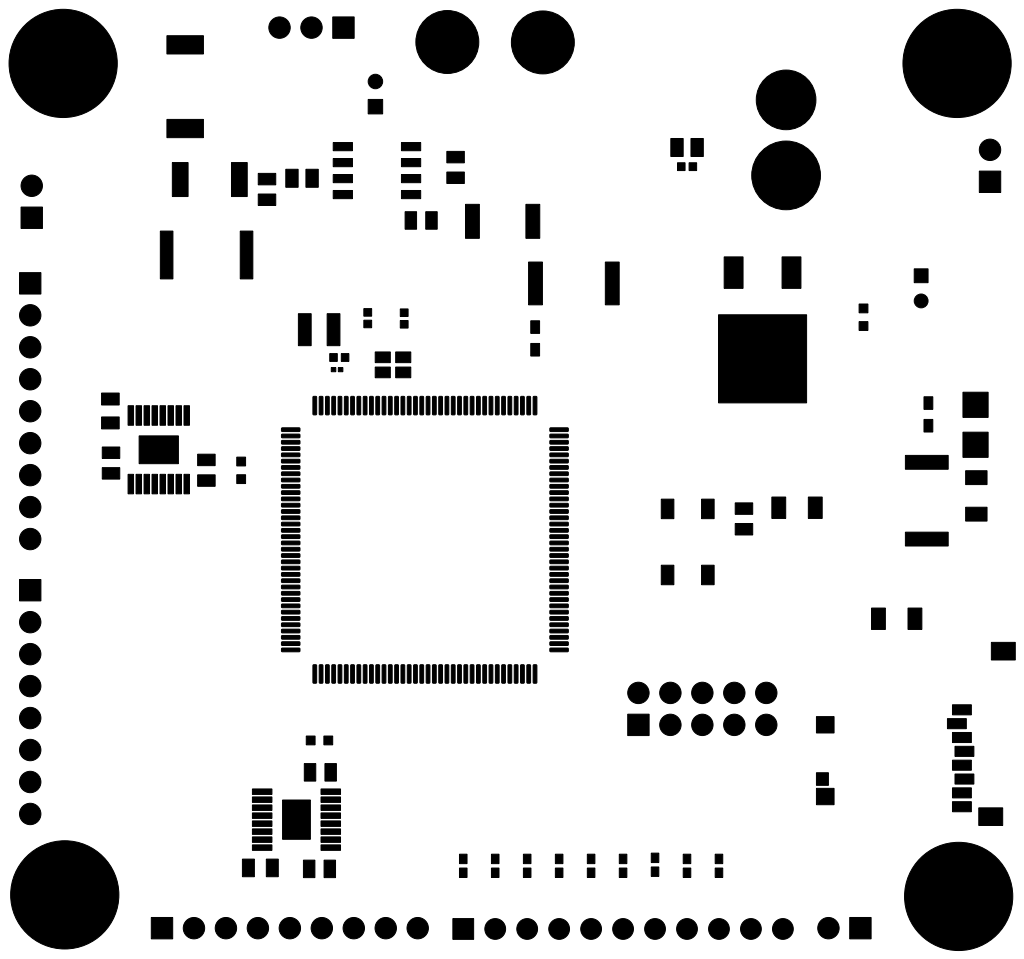
[picture p59: page 1]
