baerm56/477grp14/Main_Board/Main_Board-F_Paste.pdf

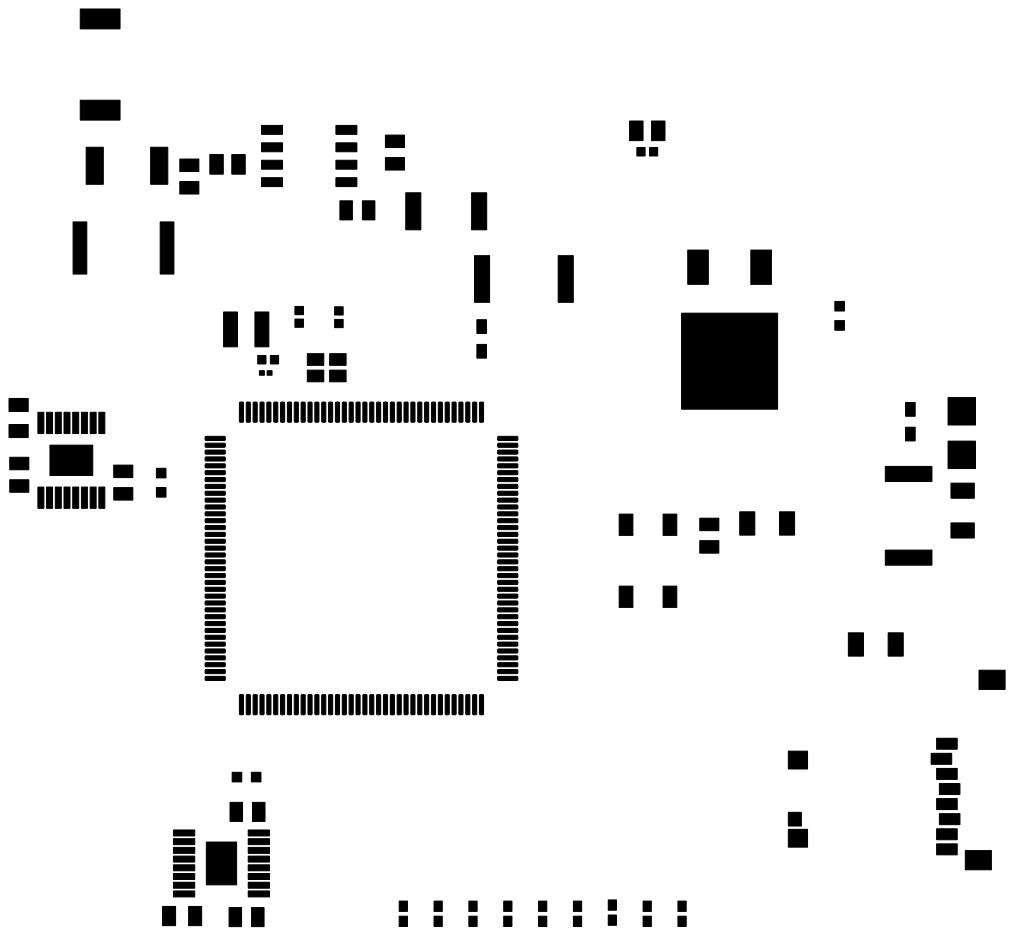
[picture p60: page 1]
