baerm56/477grp14/Main_Board/Main_Board-F_SilkS.pdf

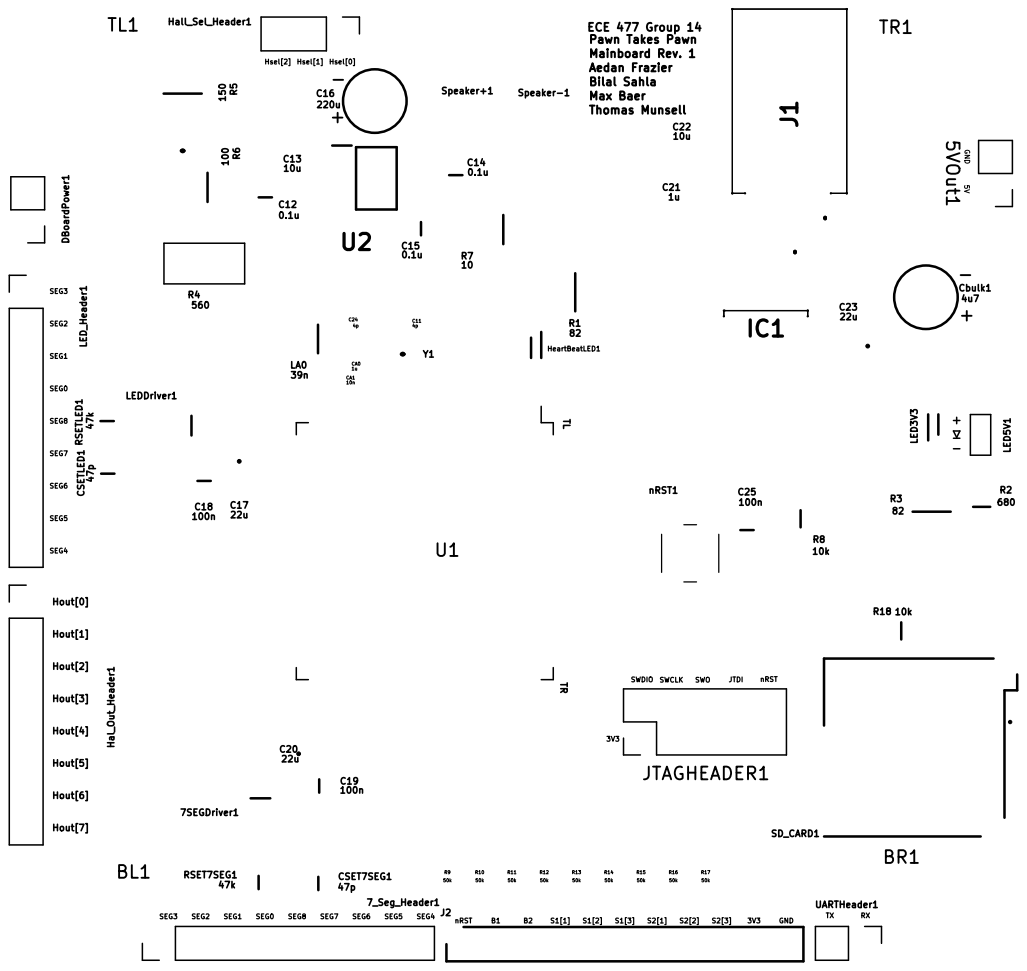
[picture p61: page 1]

Hout[7] Hout[6] Hout[5] Hout[4] Hout[3] Hout[2] Hout[1] Hout[0]
