baerm56/477grp14/Main_Board/Main_Board-In1_Cu.pdf

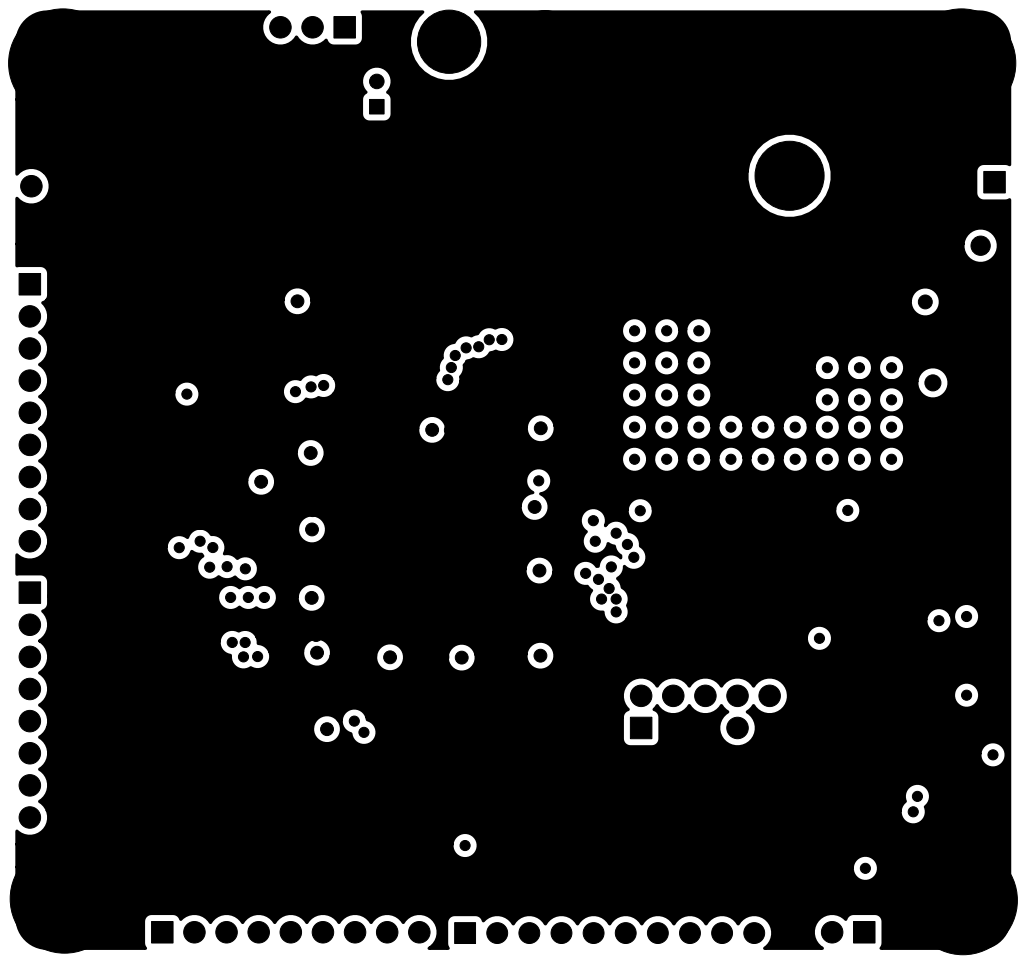
[picture p62: page 1]
