baerm56/477grp14/Main_Board/Main_Board-In2_Cu.pdf

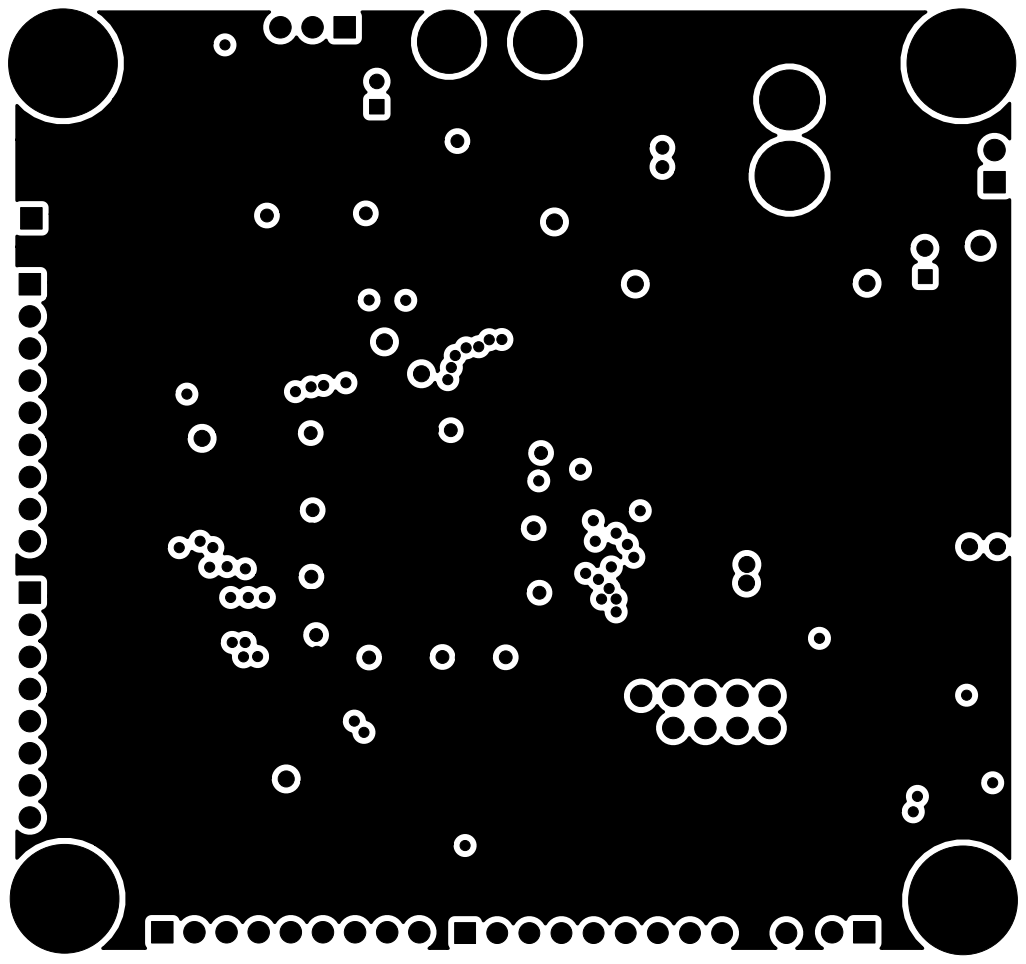
[picture p63: page 1]
