baerm56/477grp14/Main_Board/Main_Board.kicad_pcb

## KiCad design Main_Board/Main_Board.kicad_pcb (2021-11-11)

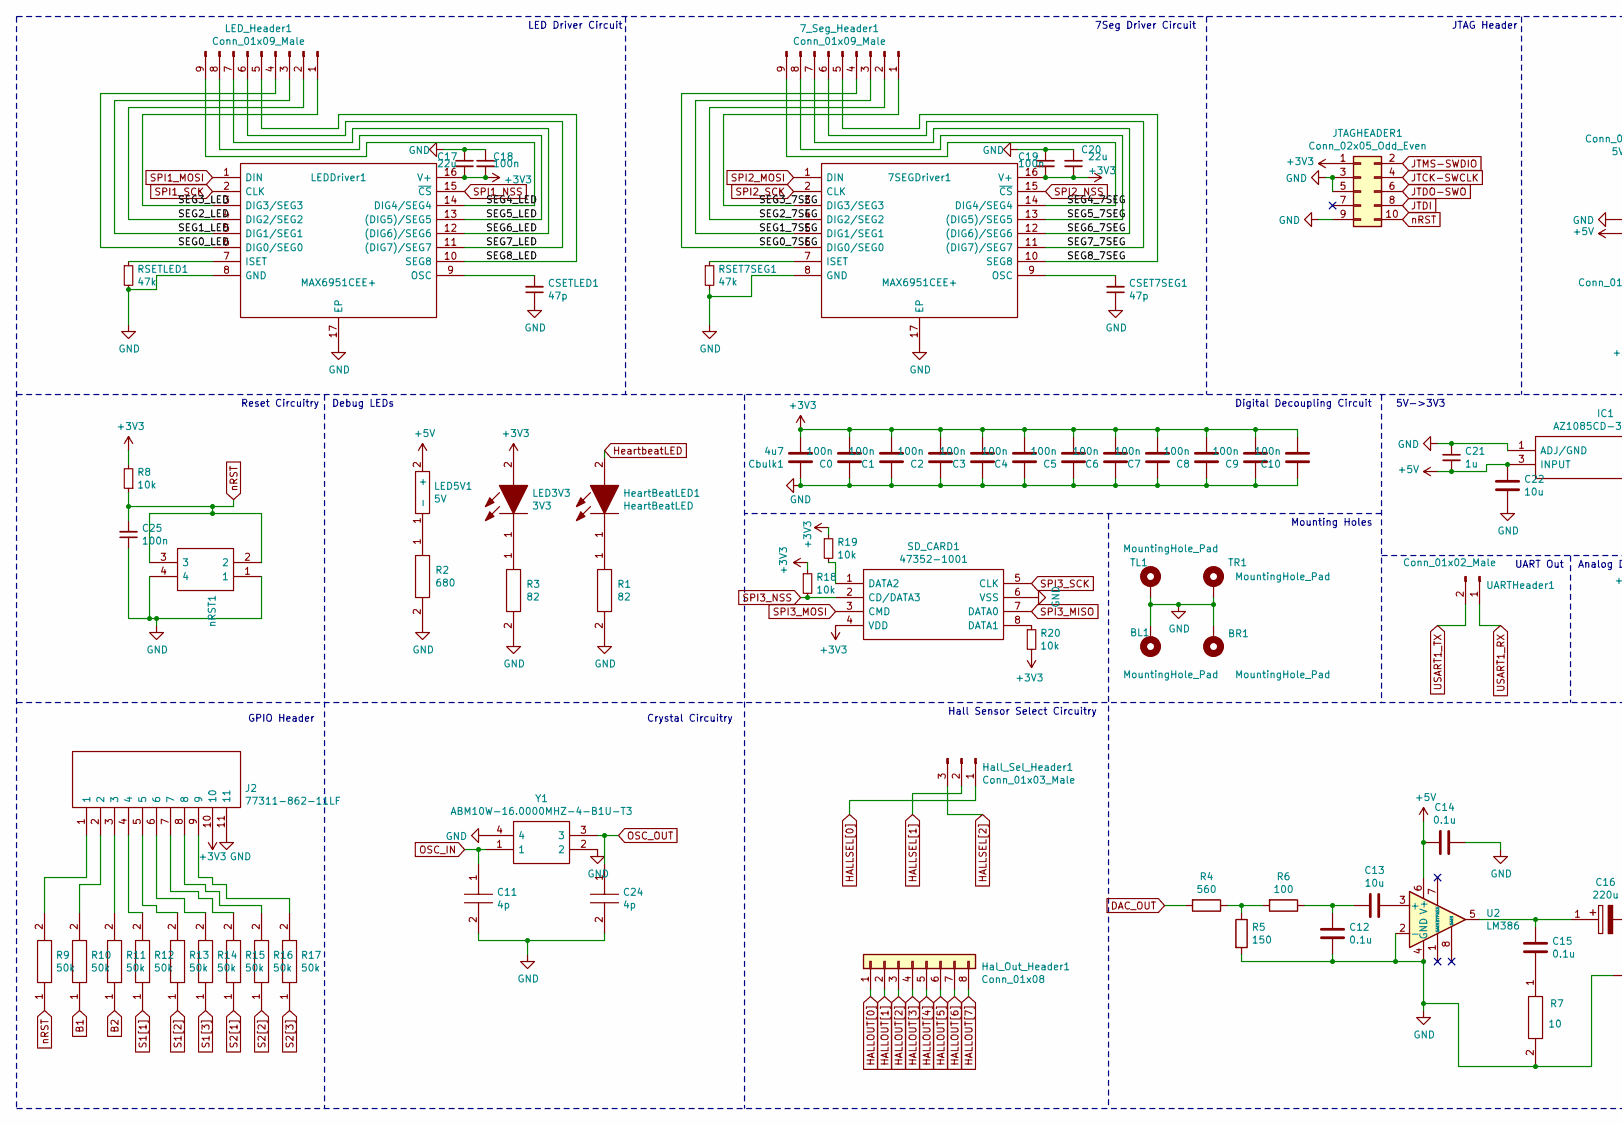
[picture p64: schematic Main_Board.sch, part in row 1, column 1]

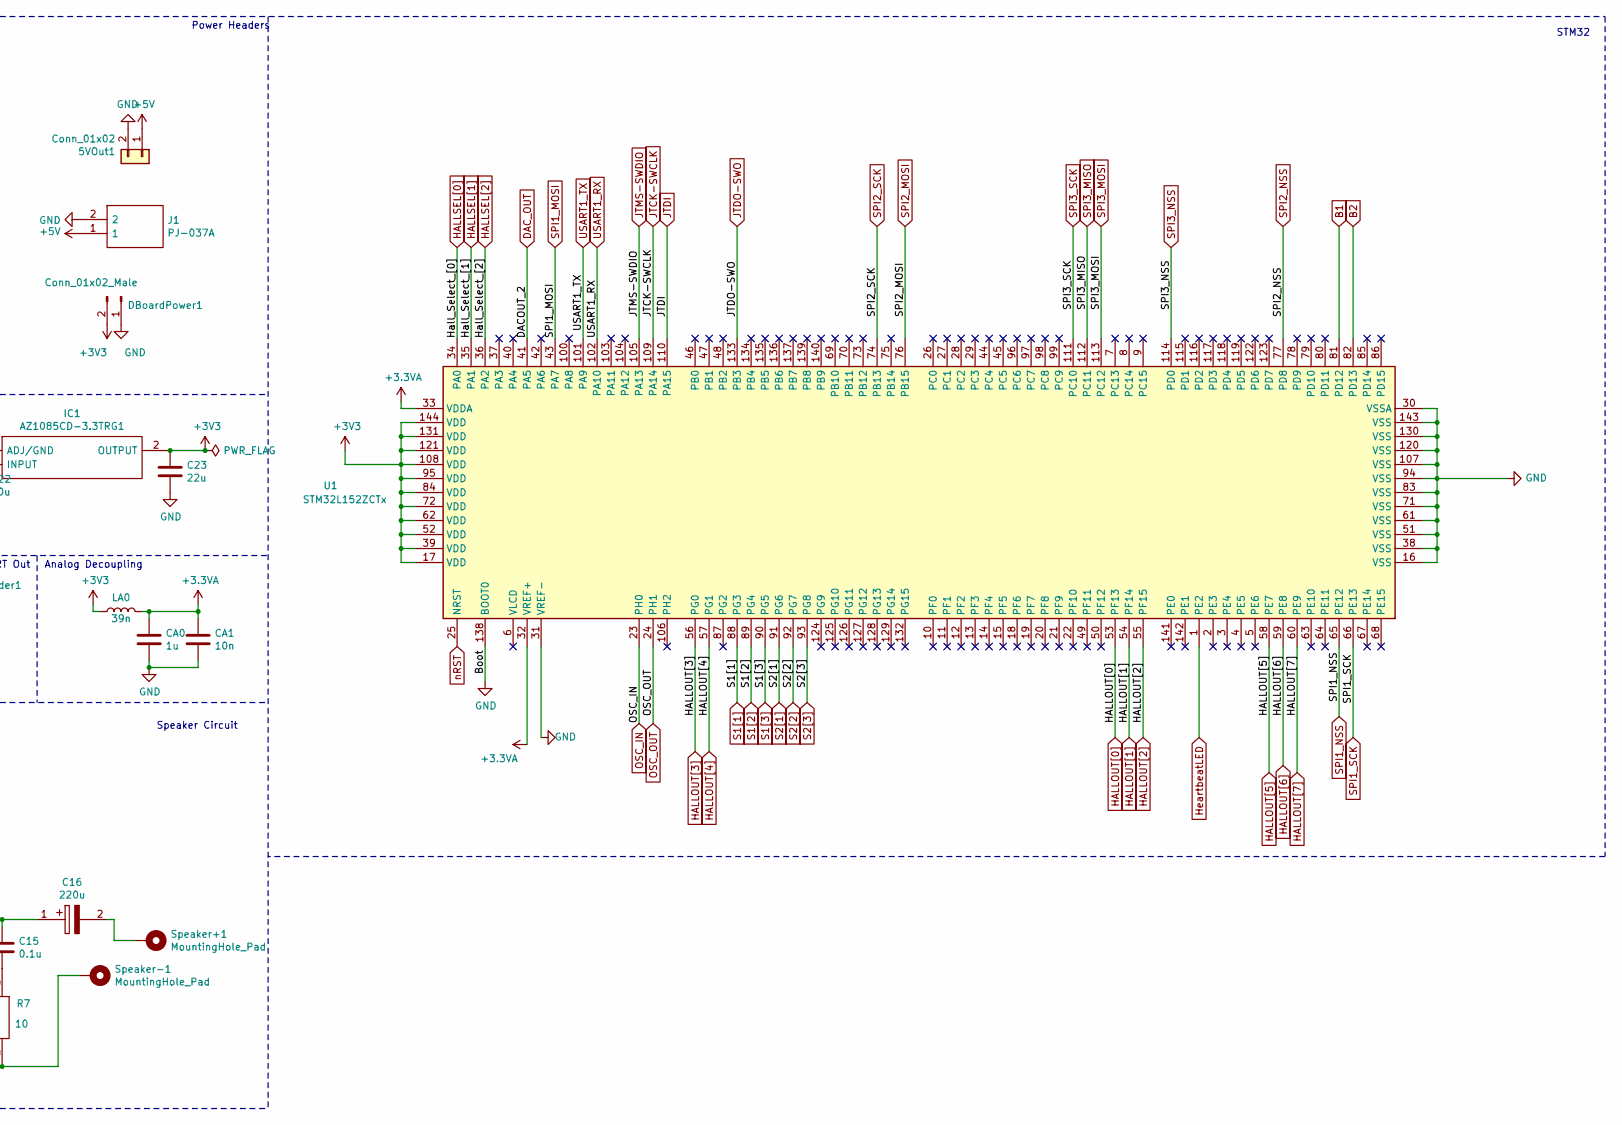
[picture p65: schematic Main_Board.sch, part in row 1, column 2]

Parts:
5VOut1: Conn_01x02; PinHeader_1x02_P2.54mm_Vertical
7SEGDriver1: MAX6951CEE+; SOP64P602X173-17N; Mouser Part Number 700-MAX6951CEE
7_Seg_Header1: Conn_01x09_Male; PinHeader_1x09_P2.54mm_Vertical
BL1: MountingHole_Pad; MountingHole_4.3mm_M4_Pad_Via
BR1: MountingHole_Pad; MountingHole_4.3mm_M4_Pad_Via
C0, C1, C2, C3, C4, C5, C6, C7, C8, C9, C10, C18, C19, C25: 100n; CAPC2012X95N
C11, C24: 4p; CAPC1005X55N; Manufacturer_Part_Number GCQ1555C1H4R0CB01D
C12, C14, C15: 0.1u; CAPC2012X95N
C13, C22: 10u; CAPC2012X140N
C16: 220u; CAPPRD200W55D500H1200; Mouser Part Number 667-ECA-0JHG221B
C17, C20, C23: 22u; C1608_Commercial
C21: 1u; CAPC1005X55N
CA0: 1u; CAPC1005X55N
CA1: 10n; CAPC0402X22N
CSET7SEG1: 47p; CAPC2012X75N
CSETLED1: 47p; CAPC2012X75N
Cbulk1: 4u7; CAPPRD200W52D500H1250
DBoardPower1: Conn_01x02_Male; PinHeader_1x02_P2.54mm_Vertical
Hal_Out_Header1: Conn_01x08; PinHeader_1x08_P2.54mm_Vertical
Hall_Sel_Header1: Conn_01x03_Male; PinHeader_1x03_P2.54mm_Vertical
HeartBeatLED1: HeartBeatLED; LEDM168X65N; Mouser Part Number 755-SMLD12BN1WT86
IC1: AZ1085CD-3.3TRG1; AZ1085CD33TRG1; Mouser Part Number 621-AZ1085CD-3.3TRG1
J1: PJ-037A; PJ037A; Mouser Part Number 490-PJ-037A
J2: 77311-862-11LF; HDRV11W62P0X254_1X11_2794X240X853P; Manufacturer_Part_Number 77311-862-11LF
JTAGHEADER1: Conn_02x05_Odd_Even; PinHeader_2x05_P2.54mm_Vertical
LA0: 39n; LQW2UAS12NG00L
LED3V3: 3V3; LEDM168X65N; Mouser Part Number 755-SMLD12BN1WT86
LED5V1: 5V; HSMA-C380
LEDDriver1: MAX6951CEE+; SOP64P602X173-17N; Mouser Part Number 700-MAX6951CEE
LED_Header1: Conn_01x09_Male; PinHeader_1x09_P2.54mm_Vertical
R1, R3: 82; RESC6432X65N; Mouser Part Number 279-CRGP2512F82R
R2: 680; RESC3116X70N; Mouser Part Number 667-ERJ-UP8F6800V
R4: 560; CRGCQ2512F3K3
R5: 150; ERJ1TRQF1R0U
R6: 100; RESC5025X70N
R7: 10; RESC5025X120N; Mouser Part Number 279-350210RFT
R8, R18, R19, R20: 10k; RESC3116X70N
R9, R10, R11, R12, R13, R14, R15, R16, R17: 50k; RESC1005X40N; Mouser Part Number 71-CRCW0402-50K-E3
RSET7SEG1: 47k; RESC2012X60N
RSETLED1: 47k; RESC2012X60N
SD_CARD1: 47352-1001; Mouser Part Number 538-47352-1001
Speaker+1: MountingHole_Pad; MountingHole_2.5mm_Pad
Speaker-1: MountingHole_Pad; MountingHole_2.5mm_Pad
TL1: MountingHole_Pad; MountingHole_4.3mm_M4_Pad_Via
TR1: MountingHole_Pad; MountingHole_4.3mm_M4_Pad_Via
U1: STM32L152ZCTx; LQFP-144_20x20mm_P0.5mm
U2: LM386; SOIC127P600X175-8N
UARTHeader1: Conn_01x02_Male; PinHeader_1x02_P2.54mm_Vertical
Y1: ABM10W-16.0000MHZ-4-B1U-T3; ABM10W400000MHZ4K1ZT3; Mouser Part Number 815-10W16-4B1UT
nRST1: A; PTS647SM50SMTR2LFS; Mouser Part Number 611-PTS647SM50SMTR2L

Connections:
+3.3VA: CA0.1, CA1.1, LA0.2, U1.32 (VREF+), U1.33 (VDDA)
+3V3: 7SEGDriver1.16 (V+), C0.2, C1.2, C2.2, C3.2, C4.2, C5.2, C6.2, C7.2, C8.2, C9.2, C10.2, C17.2, C18.2, C19.2, C20.2, C23.1, Cbulk1.2, DBoardPower1.2, IC1.2 (OUTPUT), J2.10, JTAGHEADER1.1, LA0.1, LED3V3.2, LEDDriver1.16 (V+), R8.2, R18.1, R19.1, R20.2, SD_CARD1.4 (VDD), U1.17 (VDD), U1.39 (VDD), U1.52 (VDD), U1.62 (VDD), U1.72 (VDD), U1.84 (VDD), U1.95 (VDD), U1.108 (VDD), U1.121 (VDD), U1.131 (VDD), U1.144 (VDD)
+5V: 5VOut1.1, C14.2, C21.2, C22.1, IC1.3 (INPUT), J1.1, LED5V1.2 (+), U2.6 (V+)
/SEG0_7SEG: 7SEGDriver1.6 (DIG0/SEG0), 7_Seg_Header1.4
/SEG0_LED: LEDDriver1.6 (DIG0/SEG0), LED_Header1.4
/SEG1_7SEG: 7SEGDriver1.5 (DIG1/SEG1), 7_Seg_Header1.3
/SEG1_LED: LEDDriver1.5 (DIG1/SEG1), LED_Header1.3
/SEG2_7SEG: 7SEGDriver1.4 (DIG2/SEG2), 7_Seg_Header1.2
/SEG2_LED: LEDDriver1.4 (DIG2/SEG2), LED_Header1.2
/SEG3_7SEG: 7SEGDriver1.3 (DIG3/SEG3), 7_Seg_Header1.1
/SEG3_LED: LEDDriver1.3 (DIG3/SEG3), LED_Header1.1
/SEG4_7SEG: 7SEGDriver1.14 (DIG4/SEG4), 7_Seg_Header1.9
/SEG4_LED: LEDDriver1.14 (DIG4/SEG4), LED_Header1.9
/SEG5_7SEG: 7SEGDriver1.13 ((DIG5)/SEG5), 7_Seg_Header1.8
/SEG5_LED: LEDDriver1.13 ((DIG5)/SEG5), LED_Header1.8
/SEG6_7SEG: 7SEGDriver1.12 ((DIG6)/SEG6), 7_Seg_Header1.7
/SEG6_LED: LEDDriver1.12 ((DIG6)/SEG6), LED_Header1.7
/SEG7_7SEG: 7SEGDriver1.11 ((DIG7)/SEG7), 7_Seg_Header1.6
/SEG7_LED: LEDDriver1.11 ((DIG7)/SEG7), LED_Header1.6
/SEG8_7SEG: 7SEGDriver1.10 (SEG8), 7_Seg_Header1.5
/SEG8_LED: LEDDriver1.10 (SEG8), LED_Header1.5
B1: R10.1, U1.81 (PD12)
B2: R11.1, U1.82 (PD13)
DAC_OUT: R4.2, U1.41 (PA5)
GND: 5VOut1.2, 7SEGDriver1.8 (GND), 7SEGDriver1.17 (EP), BL1.1, BR1.1, C0.1, C1.1, C2.1, C3.1, C4.1, C5.1, C6.1, C7.1, C8.1, C9.1, C10.1, C11.2, C12.2, C14.1, C17.1, C18.1, C19.1, C20.1, C21.1, C22.2, C23.2, C24.2, C25.1, CA0.2, CA1.2, CSET7SEG1.1, CSETLED1.1, Cbulk1.1, DBoardPower1.1, IC1.1 (ADJ/GND), J1.2, J2.11, JTAGHEADER1.3, JTAGHEADER1.5, JTAGHEADER1.9, LEDDriver1.8 (GND), LEDDriver1.17 (EP), R1.2, R2.2, R3.2, R5.2, R7.2, RSET7SEG1.2, RSETLED1.2, SD_CARD1.6 (VSS), Speaker-1.1, TL1.1, TR1.1, U1.16 (VSS), U1.30 (VSSA), U1.31 (VREF-), U1.38 (VSS), U1.51 (VSS), U1.61 (VSS), U1.71 (VSS), U1.83 (VSS), U1.94 (VSS), U1.107 (VSS), U1.120 (VSS), U1.130 (VSS), U1.138 (BOOT0), U1.143 (VSS), U2.2 (-), U2.4 (GND), Y1.2, Y1.4, nRST1.1, nRST1.4
HALLOUT[0]: Hal_Out_Header1.1, U1.53 (PF13)
HALLOUT[1]: Hal_Out_Header1.2, U1.54 (PF14)
HALLOUT[2]: Hal_Out_Header1.3, U1.55 (PF15)
HALLOUT[3]: Hal_Out_Header1.4, U1.56 (PG0)
HALLOUT[4]: Hal_Out_Header1.5, U1.57 (PG1)
HALLOUT[5]: Hal_Out_Header1.6, U1.58 (PE7)
HALLOUT[6]: Hal_Out_Header1.7, U1.59 (PE8)
HALLOUT[7]: Hal_Out_Header1.8, U1.60 (PE9)
HALLSEL[0]: Hall_Sel_Header1.1, U1.34 (PA0)
HALLSEL[1]: Hall_Sel_Header1.2, U1.35 (PA1)
HALLSEL[2]: Hall_Sel_Header1.3, U1.36 (PA2)
HeartbeatLED: HeartBeatLED1.2, U1.1 (PE2)
JTCK-SWCLK: JTAGHEADER1.4, U1.109 (PA14)
JTDI: JTAGHEADER1.8, U1.110 (PA15)
JTDO-SWO: JTAGHEADER1.6, U1.133 (PB3)
JTMS-SWDIO: JTAGHEADER1.2, U1.105 (PA13)
unnamed: 7SEGDriver1.7 (ISET), RSET7SEG1.1
unnamed: 7SEGDriver1.9 (OSC), CSET7SEG1.2
unnamed: C12.1, C13.2, R6.1
unnamed: C13.1, U2.3 (+)
unnamed: C15.1, C16.1, U2.5
unnamed: C15.2, R7.1
unnamed: C16.2, Speaker+1.1
unnamed: CSETLED1.2, LEDDriver1.9 (OSC)
unnamed: HeartBeatLED1.1, R1.1
unnamed: J2.1, R9.2
unnamed: J2.2, R10.2
unnamed: J2.3, R11.2
unnamed: J2.4, R12.2
unnamed: J2.5, R13.2
unnamed: J2.6, R14.2
unnamed: J2.7, R15.2
unnamed: J2.8, R16.2
unnamed: J2.9, R17.2
unnamed: LED3V3.1, R3.1
unnamed: LED5V1.1 (-), R2.1
unnamed: LEDDriver1.7 (ISET), RSETLED1.1
unnamed: R4.1, R5.1, R6.2
unnamed: R19.2, SD_CARD1.1 (DATA2)
unnamed: R20.1, SD_CARD1.8 (DATA1)
OSC_IN: C11.1, U1.23 (PH0), Y1.1
OSC_OUT: C24.1, U1.24 (PH1), Y1.3
S1[1]: R12.1, U1.88 (PG3)
S1[2]: R13.1, U1.89 (PG4)
S1[3]: R14.1, U1.90 (PG5)
S2[1]: R15.1, U1.91 (PG6)
S2[2]: R16.1, U1.92 (PG7)
S2[3]: R17.1, U1.93 (PG8)
SPI1_MOSI: LEDDriver1.1 (DIN), U1.43 (PA7)
SPI1_NSS: LEDDriver1.15 (~CS), U1.65 (PE12)
SPI1_SCK: LEDDriver1.2 (CLK), U1.66 (PE13)
SPI2_MOSI: 7SEGDriver1.1 (DIN), U1.76 (PB15)
SPI2_NSS: 7SEGDriver1.15 (~CS), U1.77 (PD8)
SPI2_SCK: 7SEGDriver1.2 (CLK), U1.74 (PB13)
SPI3_MISO: SD_CARD1.7 (DATA0), U1.112 (PC11)
SPI3_MOSI: SD_CARD1.3 (CMD), U1.113 (PC12)
SPI3_NSS: R18.2, SD_CARD1.2 (CD/DATA3), U1.114 (PD0)
SPI3_SCK: SD_CARD1.5 (CLK), U1.111 (PC10)
USART1_RX: U1.102 (PA10), UARTHeader1.1
USART1_TX: U1.101 (PA9), UARTHeader1.2
nRST: C25.2, JTAGHEADER1.10, R8.1, R9.1, U1.25 (NRST), nRST1.2, nRST1.3

Notes on the sheet:
Digital Decoupling Circuit
5V->3V3
Analog Decoupling
LED Driver Circuit
7Seg Driver Circuit
JTAG Header
STM32
UART Out
Hall Sensor Select Circuitry
Reset Circuitry
GPIO Header
Debug LEDs
Crystal Circuitry
Power Headers
Mounting Holes
Speaker Circuit

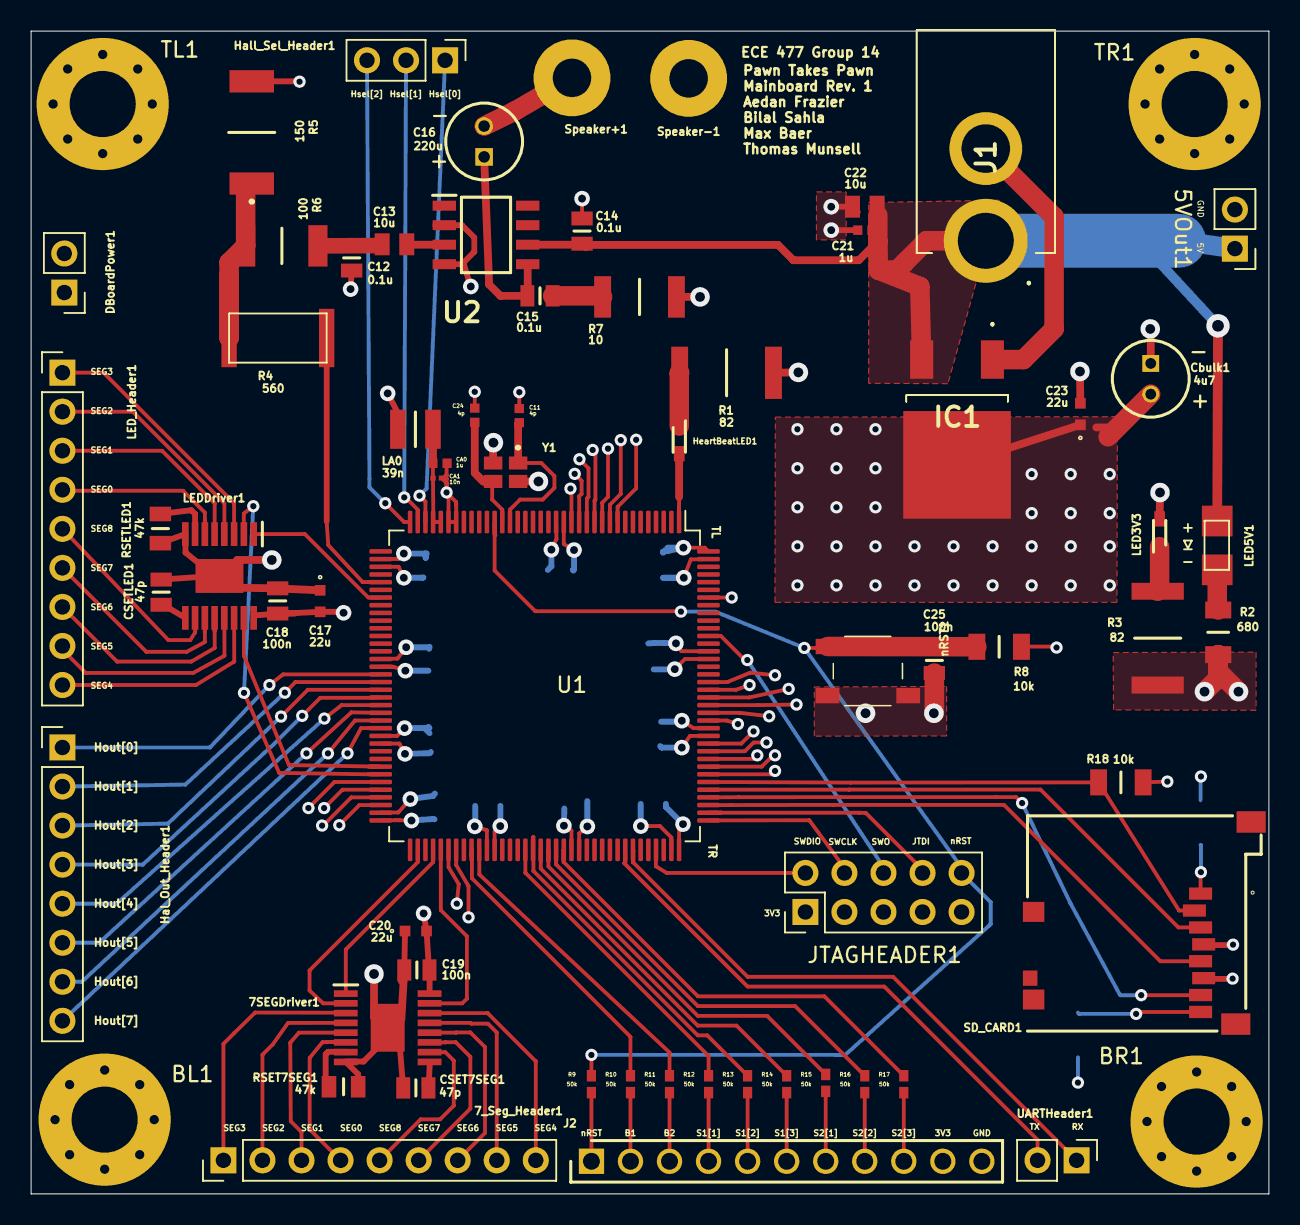
[picture p66: board Main_Board.kicad_pcb from above]

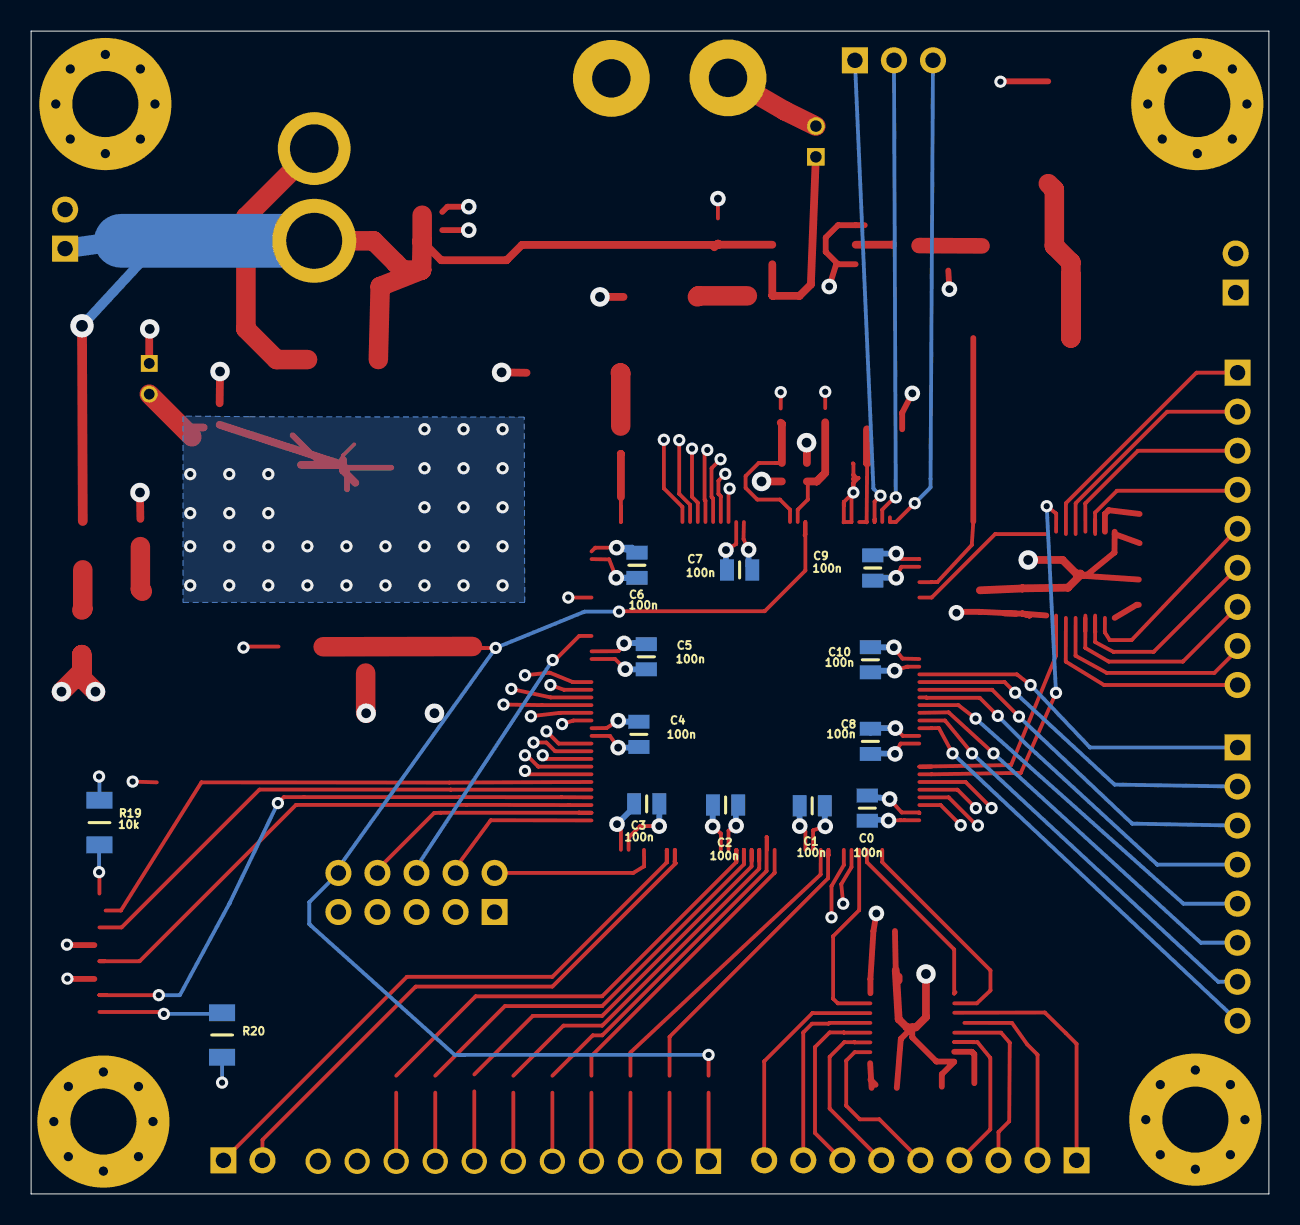
[picture p67: board Main_Board.kicad_pcb from below]

Board: 4 copper layers, 80.5 x 75.6 mm, 81 parts (13 on the bottom side), 86 nets.
