baerm56/477grp14/led_sensor/led_sensor.kicad_pcb

## KiCad design led_sensor/led_sensor.kicad_pcb (2021-10-21)

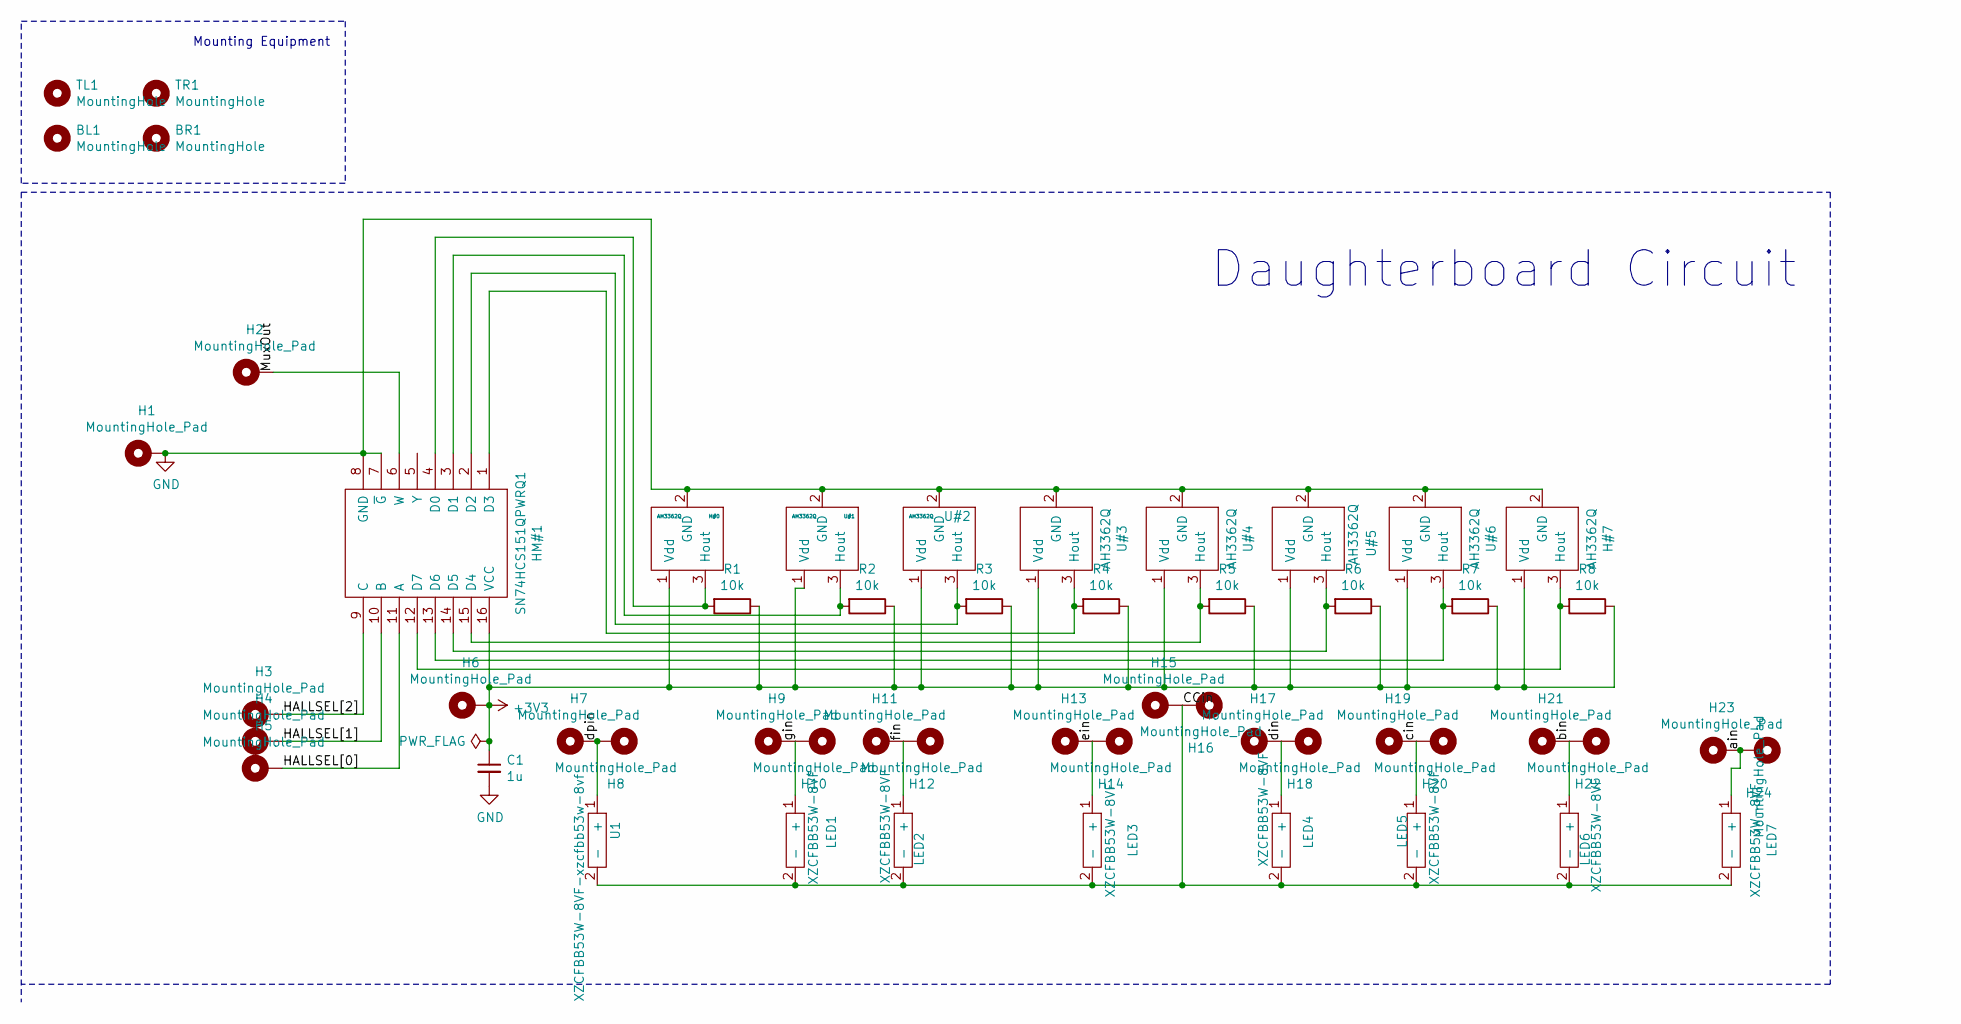
[picture p68: schematic led_sensor.sch]

Parts:
BL1: MountingHole; MountingHole_2.2mm_M2
BR1: MountingHole; MountingHole_2.2mm_M2
C1: 1u; CAPC1005X55N
H1, H2, H3, H4, H5, H6, H7, H8, H9, H10, H11, H12, H13, H14, H15, H16, H17, H18, H19, H20, H21, H22, H23, H24: MountingHole_Pad; SolderWirePad_1x01_SMD_5x10mm
H#0, H#7: AH3362Q; AH3662Q
HM#1: SN74HCS151QPWRQ1; SOP65P640X120-16N; Manufacturer_Part_Number SN74HCS151QPWRQ1; Mouser Part Number 595-SN74HCS151QPWRQ1
LED1, LED2, LED3, LED4, LED5, LED6, LED7: XZCFBB53W-8VF; HSMA-C380
R1, R2, R3, R4, R5, R6, R7, R8: 10k; RESC1608X55N
TL1: MountingHole; MountingHole_2.2mm_M2
TR1: MountingHole; MountingHole_2.2mm_M2
U1: XZCFBB53W-8VF-xzcfbb53w-8vf; HSMA-C380
U#1, U#2, U#3, U#4, U#5, U#6: AH3362Q; AH3662Q

Connections:
+3V3: C1.1, H6.1, H#0.1 (Vdd), H#7.1 (Vdd), HM#1.16 (VCC), R1.1, R2.1, R3.1, R4.1, R5.1, R6.1, R7.1, R8.1, U#1.1 (Vdd), U#2.1 (Vdd), U#3.1 (Vdd), U#4.1 (Vdd), U#5.1 (Vdd), U#6.1 (Vdd)
/CCin: H15.1, H16.1, LED1.2 (-), LED2.2 (-), LED3.2 (-), LED4.2 (-), LED5.2 (-), LED6.2 (-), LED7.2 (-), U1.2 (-); also elsewhere on the board
/HALLSEL[0]: H5.1, HM#1.11 (A)
/HALLSEL[1]: H4.1, HM#1.10 (B)
/HALLSEL[2]: H3.1, HM#1.9 (C)
/MuxOut: H2.1, HM#1.6 (W)
/ain: H23.1, H24.1, LED7.1 (+)
/bin: H21.1, H22.1, LED6.1 (+)
/cin: H19.1, H20.1, LED5.1 (+)
/din: H17.1, H18.1, LED4.1 (+)
/dpin: H7.1, H8.1, U1.1 (+); also elsewhere on the board
/ein: H13.1, H14.1, LED3.1 (+)
/fin: H11.1, H12.1, LED2.1 (+)
/gin: H9.1, H10.1, LED1.1 (+)
GND: C1.2, H1.1, H#0.2 (GND), H#7.2 (GND), HM#1.7 (~G), HM#1.8 (GND), U#1.2 (GND), U#2.2 (GND), U#3.2 (GND), U#4.2 (GND), U#5.2 (GND), U#6.2 (GND)
unnamed: H#0.3 (Hout), HM#1.4 (D0), R1.2
unnamed: H#7.3 (Hout), HM#1.12 (D7), R8.2
unnamed: HM#1.1 (D3), R4.2, U#3.3 (Hout)
unnamed: HM#1.2 (D2), R3.2, U#2.3 (Hout)
unnamed: HM#1.3 (D1), R2.2, U#1.3 (Hout)
unnamed: HM#1.13 (D6), R7.2, U#6.3 (Hout)
unnamed: HM#1.14 (D5), R6.2, U#5.3 (Hout)
unnamed: HM#1.15 (D4), R5.2, U#4.3 (Hout)

Notes on the sheet:
Mounting Equipment
Daughterboard Circuit

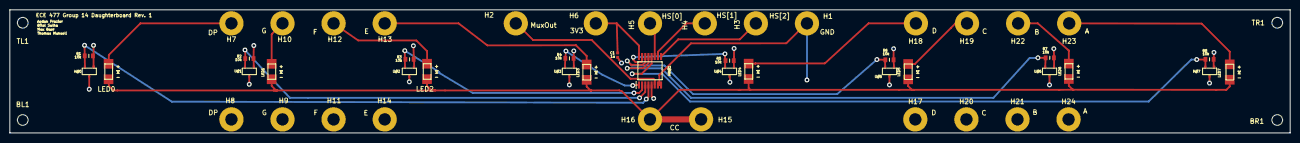
[picture p69: board led_sensor.kicad_pcb from above]

Board: 4 copper layers, 264.2 x 25.4 mm, 54 parts (0 on the bottom side), 23 nets.

Other parts of the board:
LED0: XZCFBB53W-8VF-xzcfbb53w-8vf; HSMA-C380

Their connections:
/CCin: LED0.2; also elsewhere on the board
/dpin: LED0.1; also elsewhere on the board
