baerm56/477grp14/7seg/7seg.kicad_pcb

## KiCad design 7seg/7seg.kicad_pcb (2021-10-21)

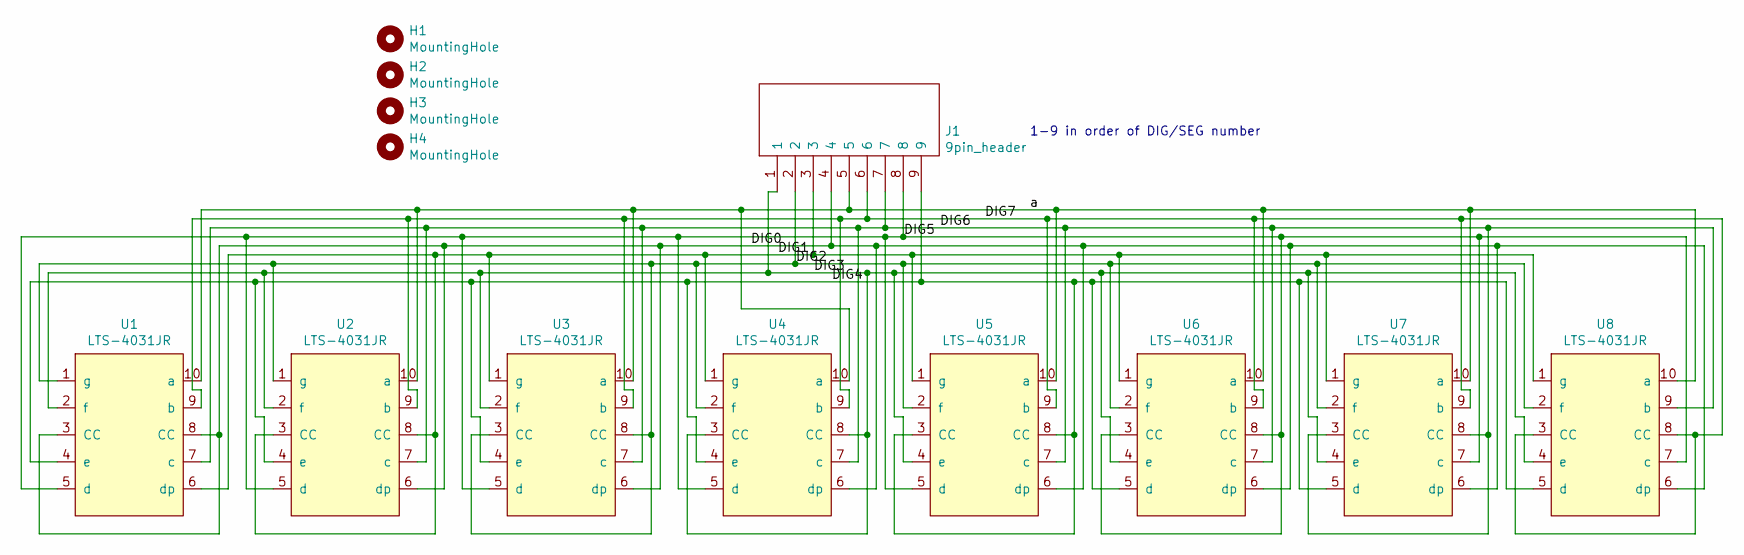
[picture p70: schematic 7seg.sch]

Parts:
H1, H2, H3, H4: MountingHole; MountingHole_2.2mm_M2_Pad
J1: 9pin_header; header; Manufacturer_Part_Number 825433-9; Mouser Part Number 571-825433-9
U1, U2, U3, U4, U5, U6, U7, U8: LTS-4031JR; 7seg

Connections:
/DIG0: J1.4, U1.3 (CC), U1.8 (CC), U2.6 (dp), U3.6 (dp), U4.6 (dp), U5.6 (dp), U6.6 (dp), U7.6 (dp), U8.6 (dp)
/DIG1: J1.3, U1.6 (dp), U2.3 (CC), U2.8 (CC), U3.1 (g), U4.1 (g), U5.1 (g), U6.1 (g), U7.1 (g), U8.1 (g)
/DIG2: J1.2, U1.1 (g), U2.1 (g), U3.3 (CC), U3.8 (CC), U4.2 (f), U5.2 (f), U6.2 (f), U7.2 (f), U8.2 (f)
/DIG3: J1.1, U1.2 (f), U2.2 (f), U3.2 (f), U4.3 (CC), U4.8 (CC), U5.4 (e), U6.4 (e), U7.4 (e), U8.4 (e)
/DIG4: J1.9, U1.4 (e), U2.4 (e), U3.4 (e), U4.4 (e), U5.3 (CC), U5.8 (CC), U6.5 (d), U7.5 (d), U8.5 (d)
/DIG5: J1.8, U1.5 (d), U2.5 (d), U3.5 (d), U4.5 (d), U5.5 (d), U6.3 (CC), U6.8 (CC), U7.7 (c), U8.7 (c)
/DIG6: J1.7, U1.7 (c), U2.7 (c), U3.7 (c), U4.7 (c), U5.7 (c), U6.7 (c), U7.3 (CC), U7.8 (CC), U8.9 (b)
/DIG7: J1.6, U1.9 (b), U2.9 (b), U3.9 (b), U4.9 (b), U5.9 (b), U6.9 (b), U7.9 (b), U8.3 (CC), U8.8 (CC)
/a: J1.5, U1.10 (a), U2.10 (a), U3.10 (a), U4.10 (a), U5.10 (a), U6.10 (a), U7.10 (a), U8.10 (a)

Notes on the sheet:
1-9 in order of DIG/SEG number

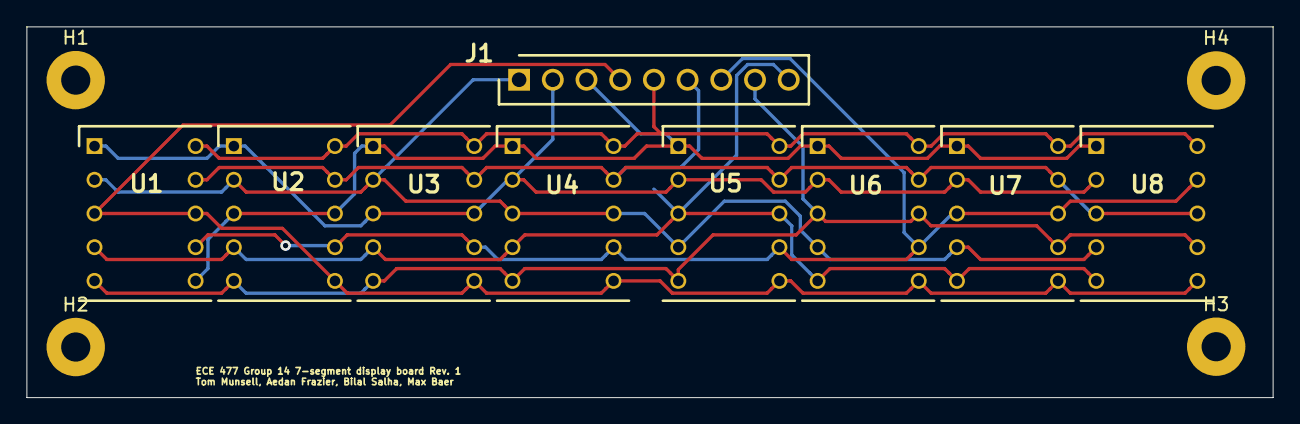
[picture p71: board 7seg.kicad_pcb from above]

Board: 2 copper layers, 93.9 x 27.9 mm, 13 parts (0 on the bottom side), 9 nets.
