baerm56/477grp14/buttons/buttons.kicad_pcb

## KiCad design buttons/buttons.kicad_pcb (2021-10-21)

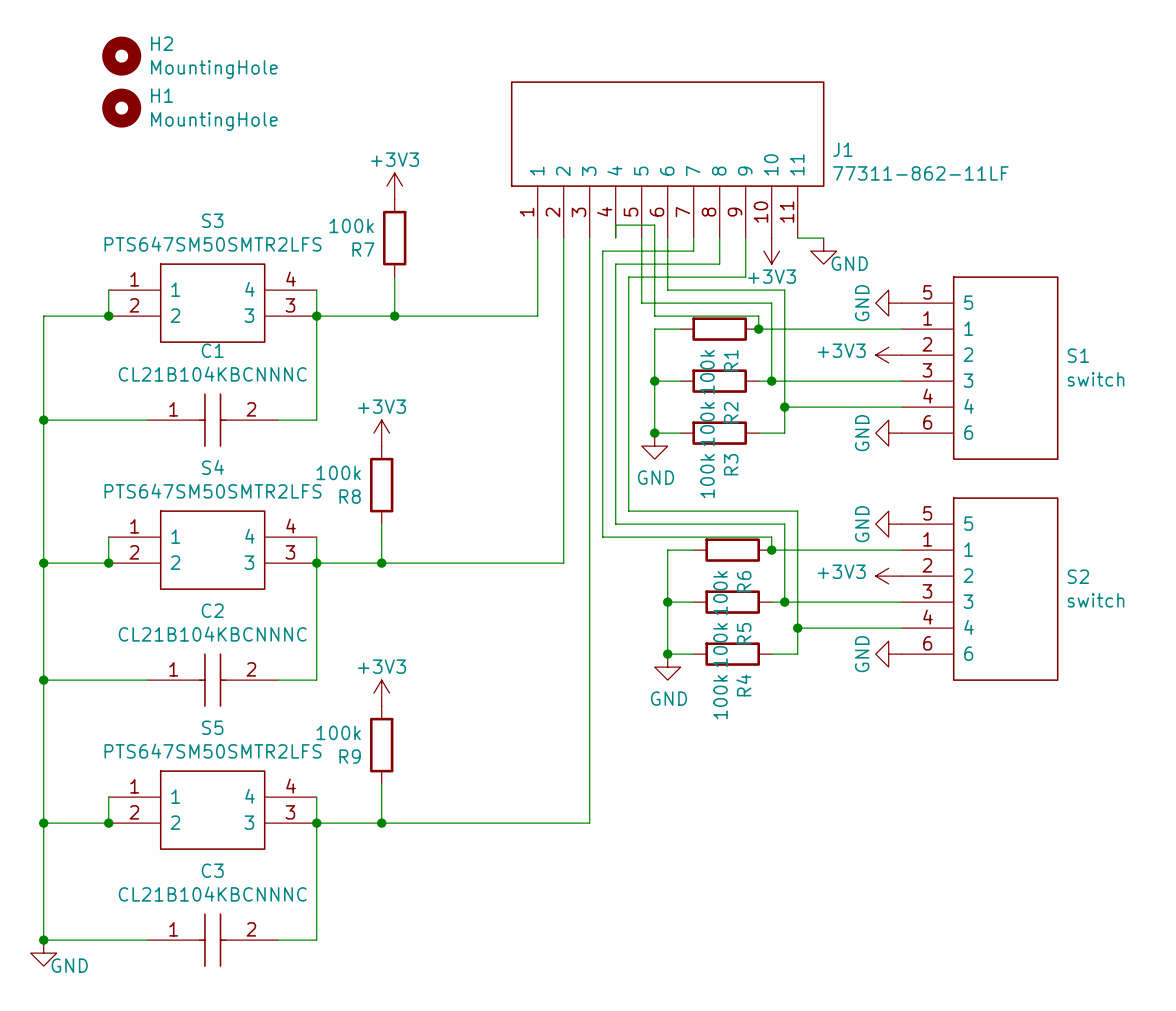
[picture p72: schematic buttons.sch]

Parts:
C1, C2, C3: CL21B104KBCNNNC; CAPC2012X95N; Mouser Part Number 187-CL21B104KBCNNNC
H1, H2: MountingHole; MountingHole_3.2mm_M3_Pad
J1: 77311-862-11LF; HDRV11W62P0X254_1X11_2794X240X853P; Manufacturer_Part_Number 77311-862-11LF
R1, R2, R3, R4, R5, R6, R7, R8, R9: 100k; RESC3116X70N
S1, S2: switch; Mouser Part Number 611-OS103011MS8QP1
S3, S4, S5: PTS647SM50SMTR2LFS; Mouser Part Number 611-PTS647SM50SMTR2L

Connections:
+3V3: J1.10, R7.2, R8.2, R9.2, S1.2, S2.2
GND: C1.1, C2.1, C3.1, J1.11, R1.2, R2.2, R3.2, R4.2, R5.2, R6.2, S1.5, S1.6, S2.5, S2.6, S3.1, S3.2, S4.1, S4.2, S5.1, S5.2
unnamed: C1.2, J1.1, R7.1, S3.3, S3.4
unnamed: C2.2, J1.2, R8.1, S4.3, S4.4
unnamed: C3.2, J1.3, R9.1, S5.3, S5.4
unnamed: J1.4, R1.1, S1.1
unnamed: J1.5, R2.1, S1.3
unnamed: J1.6, R3.1, S1.4
unnamed: J1.7, R6.1, S2.1
unnamed: J1.8, R5.1, S2.3
unnamed: J1.9, R4.1, S2.4

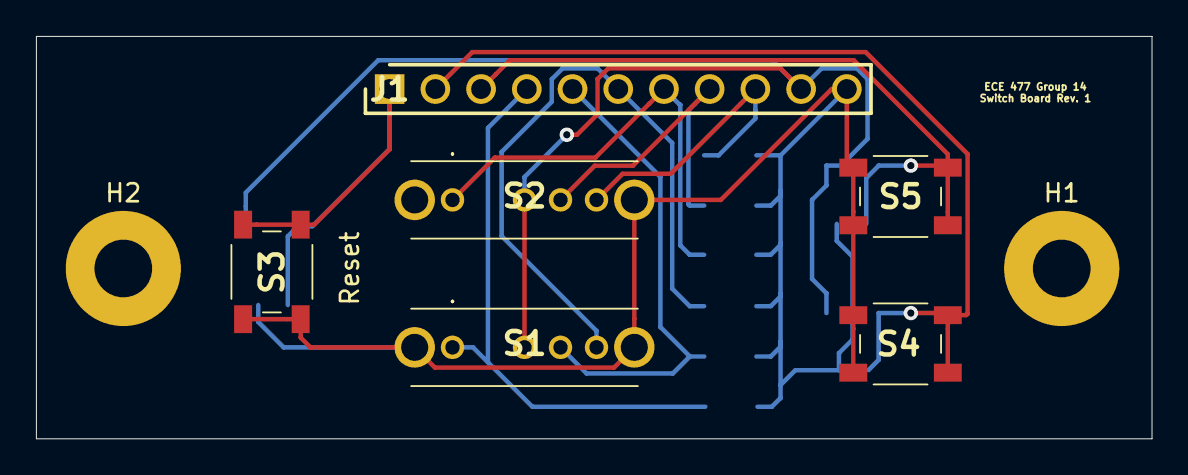
[picture p73: board buttons.kicad_pcb from above]

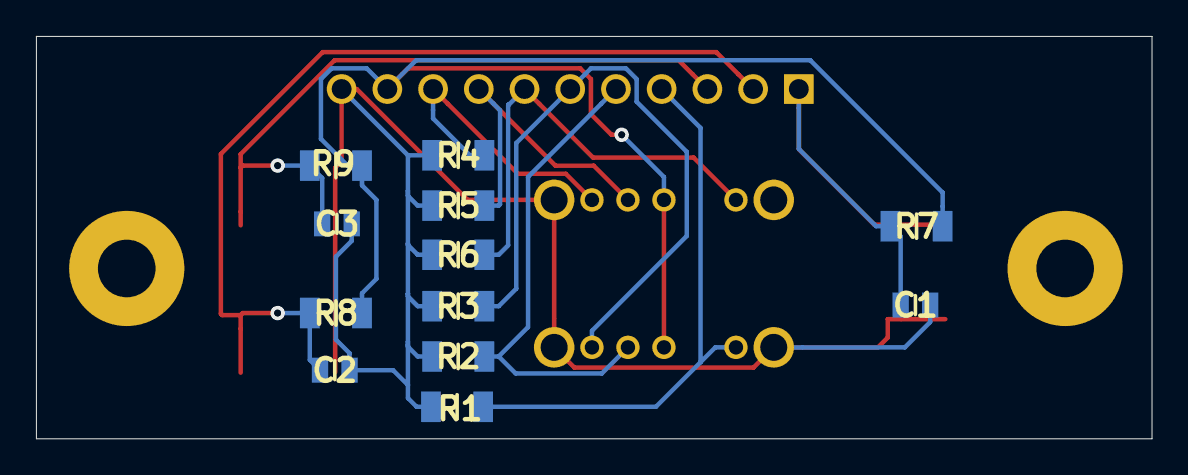
[picture p74: board buttons.kicad_pcb from below]

Board: 2 copper layers, 62.0 x 22.4 mm, 20 parts (12 on the bottom side), 11 nets.
