baerm56/477grp14/MCU/Core/Src/main.c

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
/* Includes ------------------------------------------------------------------*/
#include "main.h"
#include "fatfs.h"

/* USER CODE BEGIN Includes */
#include "leds.h"
#include "speaker.h"
#include "waveplayer.h"
#include "uart.h"
#include "tracker.h"
#include "button.h"
#include "chessclock.h"
#include "types.h"
/* USER CODE END Includes */

DAC_HandleTypeDef hdac;
DMA_HandleTypeDef hdma_dac_ch2;

SPI_HandleTypeDef hspi1;
SPI_HandleTypeDef hspi2;
SPI_HandleTypeDef hspi3;

TIM_HandleTypeDef htim2;
TIM_HandleTypeDef htim3;
TIM_HandleTypeDef htim4;
TIM_HandleTypeDef htim5;

UART_HandleTypeDef huart1;

void SystemClock_Config(void);
static void MX_GPIO_Init(void);
static void MX_SPI2_Init(void);
static void MX_TIM3_Init(void);
static void MX_SPI1_Init(void);
static void MX_SPI3_Init(void);
static void MX_DMA_Init(void);
static void MX_DAC_Init(void);
static void MX_TIM4_Init(void);
static void MX_USART1_UART_Init(void);
static void MX_TIM2_Init(void);
static void MX_TIM5_Init(void);
/* USER CODE BEGIN 0 */
enum AiDifficulty difficulty;
enum GameMode gameMode;
/* USER CODE END 0 */

/**
  * @brief  The application entry point.
  * @retval int
  */
int main(void)
{
  /* MCU Configuration--------------------------------------------------------*/

  /* Reset of all peripherals, Initializes the Flash interface and the Systick. */
   HAL_Init();

  /* Configure the system clock */
  SystemClock_Config();

  /* Initialize all configured peripherals */
  MX_GPIO_Init();
  MX_TIM3_Init();
  MX_TIM2_Init();
  MX_TIM5_Init();
  /* USER CODE BEGIN 2 */

  // Initialize LEDs //
  LEDSInit(&hspi1, 1);
  BoardLEDInit(&hspi1);
  uint8_t board[NUM_ROWS][NUM_COLS] = {0};
  writeBoardValue(&hspi1, board);

  // Initialize Chessclock //
  LEDSInit(&hspi2, 2);
  ChessTimerLEDInit(&hspi2);
  InitChessClock(&hspi2, &htim3);

  // Initialize Audio //
  SpeakerInit(&hdac, &htim4);
  WaveplayerInit(&hspi3, &hdac);

  /*if (color){
	  receiveData(&huart1, recv);
  }*/


  // Initialize Buttons
  InitButtons(&htim2, &htim5);

  /* USER CODE END 2 */

  /* Infinite loop */
  /* USER CODE BEGIN WHILE */
  // Get GameMode //
  gameMode = GetGameModeSwitchState();
  difficulty = GetDifficultySwitchState();

  // Initialize AI //
  if(gameMode == PRACTICE)
  {
	EnableUart(&huart1);
	uint8_t color = 0;
	uint8_t edum = 0;
	sendStart(&huart1, color, edum);
	sendDifficulty(&huart1, difficulty);
  }

  // Initialize Tracker component
  InitTracker(gameMode);
  while(!ValidateStartPositions())
  {
	  HAL_Delay(10);
  }

  // Splash LEDs
  for(uint8_t i = 0; i < 8; i++)
  {
	  board[i][0] = 1;
	  board[i][7] = 1;
	  board[0][i] = 1;
	  board[7][i] = 1;
  }
  writeBoardValue(&hspi1, board);

  // Start ChessClock
  StartChessClock();

  while (1)
  {
	  //TestLEDs();
	  Track();
	  HAL_Delay(10);
    /* USER CODE END WHILE */

    /* USER CODE BEGIN 3 */
  }
  /* USER CODE END 3 */
}

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
/* USER CODE BEGIN 4 */

// Chess clock callback
void HAL_TIM_PeriodElapsedCallback(TIM_HandleTypeDef *htim)
{
  if (htim->Instance == TIM3) {
	  ChessClockTimerCallback(GetCurrentTurn());
  }
  if (htim->Instance == TIM2) {
	  Button1DebounceTimerCallback();
  }
  if (htim->Instance == TIM5) {
	  Button2DebounceTimerCallback();
  }
}

// Button0 and Button1 callbacks
void HAL_GPIO_EXTI_Callback(uint16_t GPIO_Pin)
{
	if(GPIO_Pin == BUTTON1_Pin)
	{
		Button1Callback();
	}
	else if(GPIO_Pin == BUTTON2_Pin)
	{
		Button2Callback();
	}
	else if (GPIO_Pin == SWITCH2_1_Pin ||
			 GPIO_Pin == SWITCH2_2_Pin ||
			 GPIO_Pin == SWITCH2_3_Pin){
		enum AiDifficulty diff = GetDifficultySwitchState();
		if (diff != difficulty){
			sendDifficulty(&huart1, diff);
			difficulty = diff;
		}
	}
}
/* USER CODE END 4 */
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
