baerm56/477grp14/pi/ChessAI.py

import chess
import chess.engine
import serial
import time

class chessGame():
    def __init__(self, path='/home/pi/AICode/stockfish', difficulty=20):
        self.engine = chess.engine.SimpleEngine.popen_uci(path)
        self.board = chess.Board()
        self.cpu_turn = False
        self.edu_mode = False

        self.engine.configure({"Skill Level": difficulty}) # can be 0-20

    def send_move(self, move):
        if type(move) is not chess.Move:
            if move[0] and move [2] not in ['a', 'b', 'c', 'd', 'e', 'f', 'g', 'h']:
                return False
            if move[1] and move[3] not in ['1', '2', '3', '4', '5', '6', '7', '8']:
                return False
            move = chess.Move.from_uci(move)
        if move not in self.board.legal_moves:
            return False
        self.board.push(move)
        return True

    def get_best_move(self, time=2):
        return self.engine.play(self.board, chess.engine.Limit(time=time)).move

    def check_game_over(self):
        return self.board.is_game_over()
        
    def print_board(self):
        print(self.board)
        print('')

    def change_turn(self):
        self.cpu_turn = not self.cpu_turn

class serialConnection():
    def __init__(self, baudrate=9600):
        #self.port = serial.Serial("/dev/serial0", baudrate, parity=serial.PARITY_EVEN)
        self.port = serial.Serial("/dev/serial0", baudrate)

    def send_data(self, data):
        byte_data = str.encode(data)
        self.port.write(byte_data)
        print("AI: " + data + "\n")

    def receive_data(self):
        print("Waiting for data!")
        byte_data = self.port.read(4)
        data = byte_data.decode("utf-8")
        #data = input()
        print(data)
        return data


def CPUTurn(game, uart):
    cpu_move = game.get_best_move()
    while not game.send_move(cpu_move):
        print("Not Valid CPU Move!")
        cpu_move = game.get_best_move()
    uart.send_data(str(cpu_move) + '-')

def checkCases(input):
    if input in ["STOP", "STRT", "DF01", "DF08", "DF15"]:
        return True
    return False
    

def playerTurn(game, uart):
    player_move = uart.receive_data()                   # Get message from MCU

    isSpecial = checkCases(player_move)                 # Check if message is special case
    if isSpecial:
        return player_move

    while not game.send_move(player_move):
        print("Not Valid Move!")
        time.sleep(0.5)
        uart.send_data('-----')
        player_move = uart.receive_data()
        isSpecial = checkCases(player_move)                
        if isSpecial:
            return player_move
    
    return "PASS"

def runChess():
    global strt
    uart = serialConnection()
    game = chessGame()

    while(not strt and uart.receive_data() != 'STRT'):
        pass

    '''if (uart.receive_data() == "BLCK"):
        game.change_turn()

    if (uart.receive_data() == "EDUM"):
        game.edu_mode = True
        game.change_turn()

    diff = uart.receive_data()

    if (diff in ["DF05", "DF10", "DF15", "DF20"]):
        game.engine.configure({"Skill Level": int(diff[2:])})'''

    strt = 0

    if not game.edu_mode:
        while not game.check_game_over():
            game.print_board()

            if game.cpu_turn:
                CPUTurn(game, uart)
                game.change_turn()
            else:
                result = playerTurn(game, uart)
                if result == "PASS":
                    game.change_turn()
                elif result == "STOP":
                    break
                elif result == "STRT":
                    strt = 1
                    break
                elif result[0:2] == "DF":
                    game.engine.configure({"Skill Level": int(result[2:])}) # can be 0-20
    else:
        while not game.check_game_over():
            game.print_board()
            if game.cpu_turn:
                move = str(game.get_best_move())
                uart.send_data(move + '-')
                game.change_turn()
            else:
                result = playerTurn(game, uart)
                if result == "PASS":
                    game.change_turn()
                elif result == "STOP":
                    break
                elif result == "STRT":
                    strt = 1
                    break
                elif result[0:2] == "DF":
                    game.engine.configure({"Skill Level": int(result[2:])}) # can be 0-20



    game.engine.quit()

strt = 0

while(1):
    print('--------- NEW GAME ---------')
    runChess()
