baerm56/477grp14/MCU/Core/Inc/waveplayer.h

#ifndef WAVEPLAYER_H_
#define WAVEPLAYER_H

#include "stm32l1xx_hal.h"
#include "fatfs.h"

#define AUDIO_BUFFER_SIZE  4096

typedef struct
{
  uint32_t   ChunkID;       /* 0 */ // RIFF
  uint32_t   FileSize;      /* 4 */ // Size of file - 8 bytes
  uint32_t   FileFormat;    /* 8 */ // WAVE
  uint32_t   SubChunk1ID;   /* 12 */// fmt
  uint32_t   SubChunk1Size; /* 16*/ // 16
  uint16_t   AudioFormat;   /* 20 */// PCM = 1
  uint16_t   NbrChannels;   /* 22 */// Mono = 1, Stereo = 2
  uint32_t   SampleRate;    /* 24 */// 8000, 11020, etc

  uint32_t   ByteRate;      /* 28 */
  uint16_t   BlockAlign;    /* 32 */
  uint16_t   BitPerSample;  /* 34 */// 8, 16
  uint32_t   SubChunk2ID;   /* 36 */// data
  uint32_t   SubChunk2Size; /* 40 */

}WAV_Header;

typedef enum
{
  WAVEPLAYER_IDLE=0,
  WAVEPLAYER_HALFBUFFER,
  WAVEPLAYER_FULLBUFFER,
  WAVEPLAYER_EOF,
}WAVEPLAYER_E;

void WaveplayerInit(SPI_HandleTypeDef * hspi, DAC_HandleTypeDef *hdac);
void PlayAudio(const char* filePath, DAC_HandleTypeDef * hdac);
void ProcessAudio();
int GetAudioStatus();
void GetFile(const char* filePath);
void prepAudio(SPI_HandleTypeDef * hspi1, SPI_HandleTypeDef * hspi2, DAC_HandleTypeDef *hdac);
void resetAudio(SPI_HandleTypeDef * hspi1, SPI_HandleTypeDef * hspi2, DAC_HandleTypeDef *hdac);

#endif /* WAVEPLAYER_H */
