baerm56/477grp14/(commit log)

2021-09-24 Added STM32 files
2021-09-27 Added new LED script
2021-09-29 Added SPI test
2021-09-30 Wrote some LED code
2021-10-01 PCB Stuff
    [Main_Board.kicad_pcb, Main_Board.sch, Main_Board_1.1.sch, Main_Board_1.2.sch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]
2021-10-03 Working on DMA
2021-10-04 DAC and DMA now working
2021-10-05 Updated PCB
    [Main_Board.kicad_pcb, led_sensor.kicad_pcb]
2021-10-07 added 7-segment schematic
    [7seg.kicad_pcb, 7seg.sch]
2021-10-07 Updated Mainboard
    [Main_Board.csv, Main_Board.kicad_pcb, Main_Board.sch]
2021-10-11 7-segment layout
    [7seg.sch]
2021-10-11 7-segment footprints
2021-10-11 add rescued symbols so kicad doesn't complain every time?
    [Main_Board.sch]
2021-10-11 add rescued symbols so kicad doesn't complain every time? 2
2021-10-12 Added switch board, reset circuit
    [Main_Board.kicad_pcb, Main_Board.sch, buttons.kicad_pcb, buttons.sch]
2021-10-12 more library changes
    [7seg.kicad_pcb, 7seg.sch, buttons.sch, led_sensor.sch]
2021-10-12 8 Hall Sensor
    [Main_Board.kicad_pcb, Main_Board.sch, led_sensor.sch]
2021-10-13 ''Updates 12-10"
    [Main_Board.kicad_pcb, Main_Board.sch]
2021-10-13 fixed reverse biased LEDs
    [Main_Board.sch, led_sensor.kicad_pcb, led_sensor.sch]
2021-10-13 added DC jack, miscellaneous
    [Main_Board.kicad_pcb, Main_Board.sch]
2021-10-13 cleaned up directories, silkscreen
    [7seg.kicad_pcb, Main_Board.kicad_pcb, Main_Board_1.1.sch, Main_Board_1.2.sch, buttons.kicad_pcb, buttons.sch, led_sensor.kicad_pcb]
2021-10-13 changed LM386 package to match what I bought
    [Main_Board.kicad_pcb, Main_Board.sch]
2021-10-13 changed board outline
    [Main_Board.kicad_pcb]
2021-10-14 Schem Pictures
    [Main_Board.kicad_pcb]
2021-10-14 through hole vias
    [Main_Board.kicad_pcb, led_sensor.kicad_pcb]
2021-10-14 More screenshots
    [Main_Board.kicad_pcb]
2021-10-14 Added reset button, fixed 7seg pin order
    [7seg.kicad_pcb, 7seg.sch, buttons.kicad_pcb, buttons.sch]
2021-10-14 Added Pullups to Daughterboard
    [led_sensor.kicad_pcb, led_sensor.sch]
2021-10-14 Updated Screenshots
    [led_sensor.kicad_pcb, led_sensor.sch]
2021-10-14 switched symbols
    [Main_Board.kicad_pcb, led_sensor.kicad_pcb, led_sensor.sch]
2021-10-15 final Rev1 changes. increased heatsink area, flipped LEDs again, increased button mount hole size
    [Main_Board.kicad_pcb, Main_Board.sch, buttons.kicad_pcb, buttons.sch, led_sensor.kicad_pcb, led_sensor.sch]
2021-10-16 Some updates
    [Main_Board.kicad_pcb, Main_Board.sch]
2021-10-17 'switched uart'
    [Main_Board.kicad_pcb]
2021-10-20 added two more buttons
    [buttons.kicad_pcb, buttons.sch]
2021-10-20 edited main board headers for buttons, daughterboard power
    [Main_Board.kicad_pcb, Main_Board.sch, buttons.kicad_pcb, led_sensor.kicad_pcb]
2021-10-20 changed audio resistor value, same package
    [Main_Board.kicad_pcb, Main_Board.sch]
2021-10-20 changed 5V trace
    [Main_Board.kicad_pcb]
2021-10-20 gerbers 2.0
    [7seg-B_Cu.gbr, 7seg-B_Mask.gbr, 7seg-B_SilkS.gbr, 7seg-Edge_Cuts.gbr, 7seg-F_Cu.gbr, 7seg-F_Mask.gbr, 7seg-F_SilkS.gbr, 7seg-job.gbrjob]
2021-10-21 Updated LED, speaker, tracker code for pins on dev board
2021-10-21 ESD and Pullups
    [Main_Board.kicad_pcb, Main_Board.sch]
2021-10-21 Added Silkscreen info
    [Main_Board.kicad_pcb]
2021-10-21 new main board gerbers
    [Main_Board-B_Cu.gbr, Main_Board-B_Mask.gbr, Main_Board-B_Paste.gbr, Main_Board-B_SilkS.gbr, Main_Board-Edge_Cuts.gbr, Main_Board-F_Cu.gbr, Main_Board-F_Mask.gbr, Main_Board-F_Paste.gbr]
2021-10-22 minor tweaks
    [Main_Board.kicad_pcb]
2021-11-11 Updated Button
    [Main_Board.kicad_pcb, Main_Board.sch]
2021-11-29 I really hope this doesn't break everything
    [IHateEverything3.ioc, leds.c, leds.h, main.c, main.h, speaker.c, speaker.h, tracker.c]
2021-11-29 Added in improved tracker code with legal move detection and integration with LEDs. Added test for tracker with just one piece on the board.
2021-11-30 Added button EXTI callbacks and debouncing. Added more sophisticated test for legal piece detection.
2021-12-03 Evertyhing except castling and timer work
2021-12-03 Added support for switch interface. Implemented chess clock. Relocated AI invocation in tracker.c
2021-12-04 Castling works with AI. Timer gets updated with each AI move instead of each second for practice mode
2021-12-06 Fixed playing piece from opposite team from switching the turn to them.
    [main.c, tracker.c, tracker.h]
